NT7S/WillametteTransceiver/Pics/Pads2.png

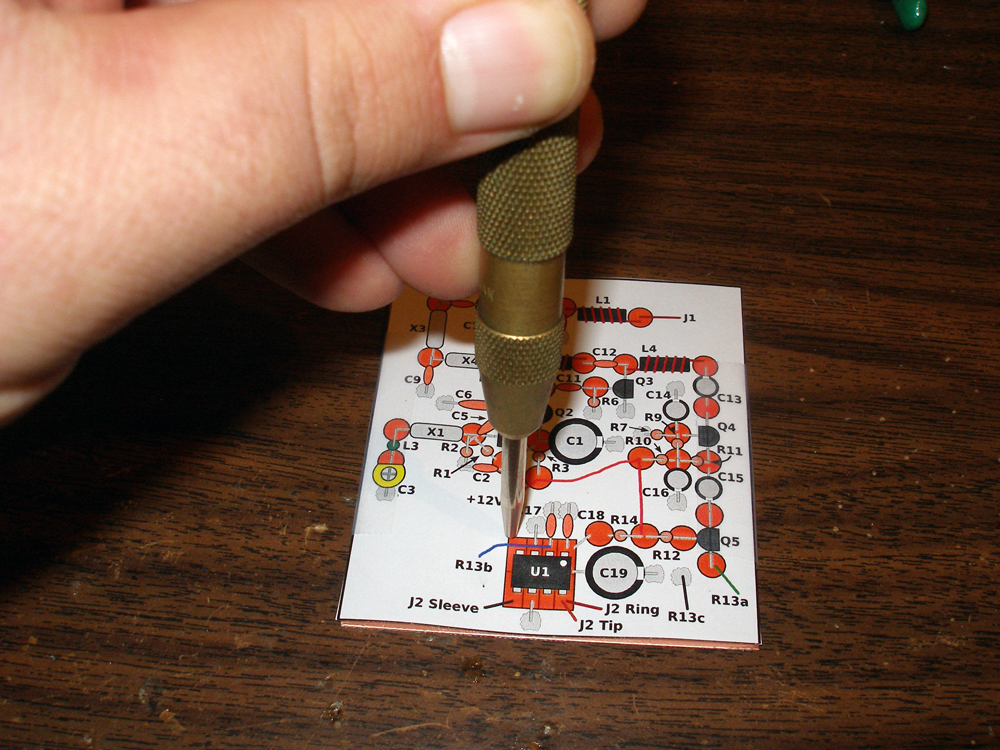
Pics/Pads2.png
