NT7S/WillametteTransceiver/Pics/Diode3.png

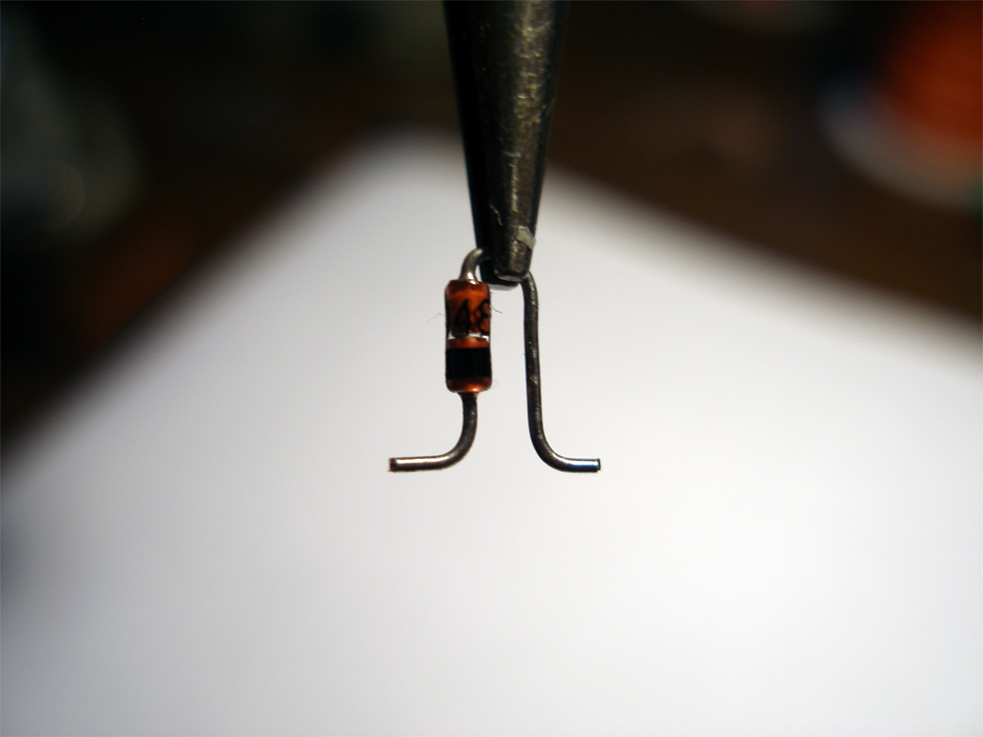
Pics/Diode3.png
