NT7S/WillametteTransceiver/Peaked AF Filter.pdf

Sheet1

Frequency Voltage (pp) dB
1.00E+02 | 6.560 | 0
2.00E+02 | 7.200 | 0.81
3.00E+02 | 7.600 | 1.28
4.00E+02 | 7.840 | 1.55
5.00E+02 | 8.080 | 1.81
6.00E+02 | 8.240 | 1.98
7.00E+02 | 8.240 | 1.98
8.00E+02 | 8.240 | 1.98
9.00E+02 | 8.320 | 2.06
1.00E+03 | 8.320 | 2.06
1.50E+03 | 8.080 | 1.81
2.00E+03 | 8.000 | 1.72
3.00E+03 | 7.600 | 1.28
4.00E+03 | 6.680 | 0.16
5.00E+03 | 2.960 | -6.91
7.50E+03 | 0.784 -18.45
1.00E+04 | 0.260 -28.04
1.50E+04 | 0.084 -37.85
2.00E+04 | 0.032 -46.24

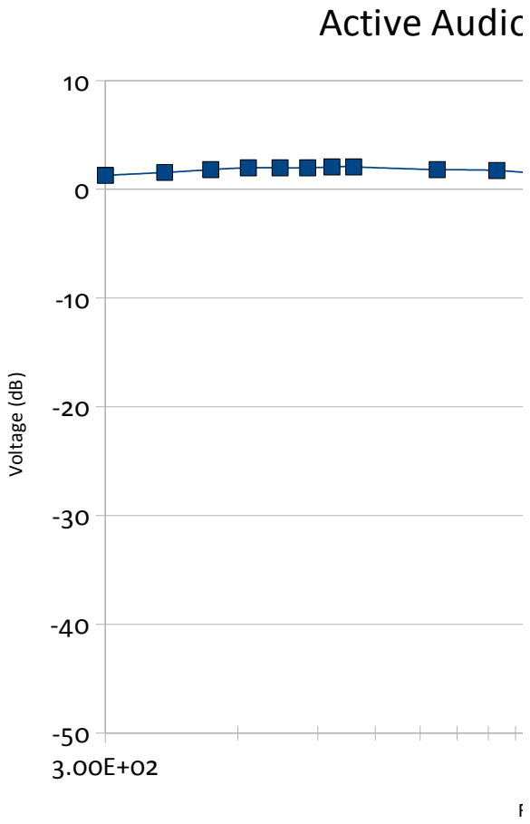
[picture p3: figure]
Active Audio Filter Response; Frequency (Hz); Voltage (dB)

Sheet1

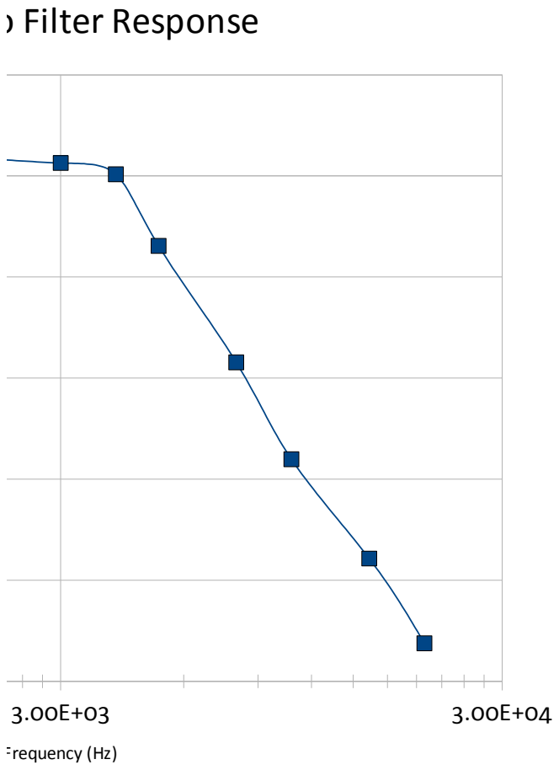
[picture p4: figure]
Active Audio Filter Response; Frequency (Hz)
