NT7S/WillametteTransceiver/Broadband-Noise-Generator.png

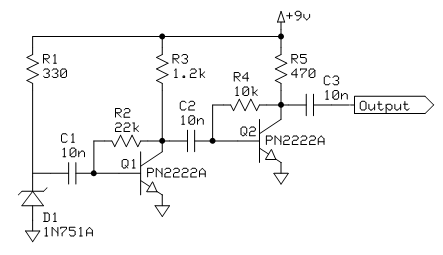
Broadband-Noise-Generator.png
