NT7S/WillametteTransceiver/New-Willamette-AF-Filter-Re.png

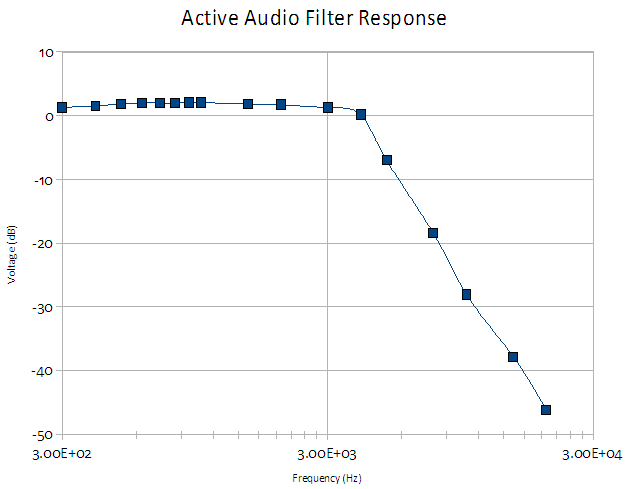
New-Willamette-AF-Filter-Re.png
