NT7S/WillametteTransceiver/Pics/Beta1.png

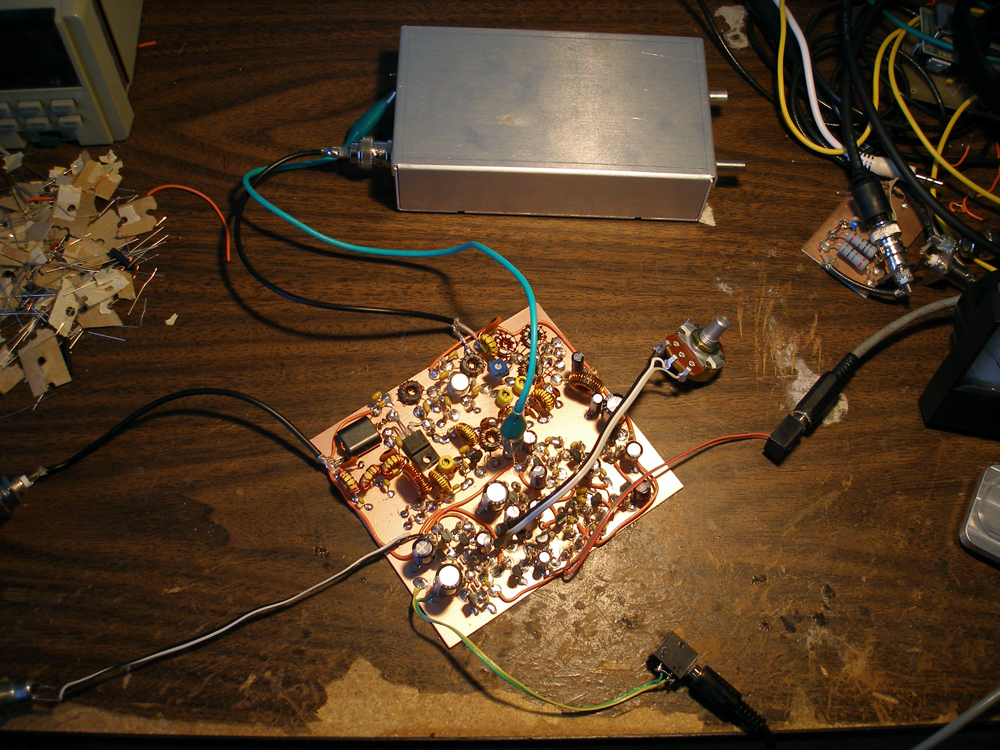
Pics/Beta1.png
