NT7S/WillametteTransceiver/Pics/Beta2.png

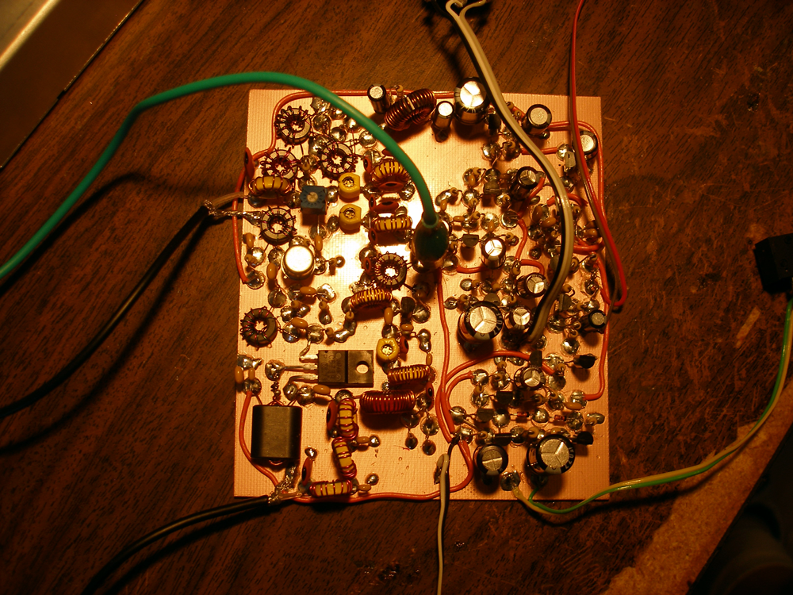
Pics/Beta2.png
