NT7S/WillametteTransceiver/Pics/Bifilar1.png

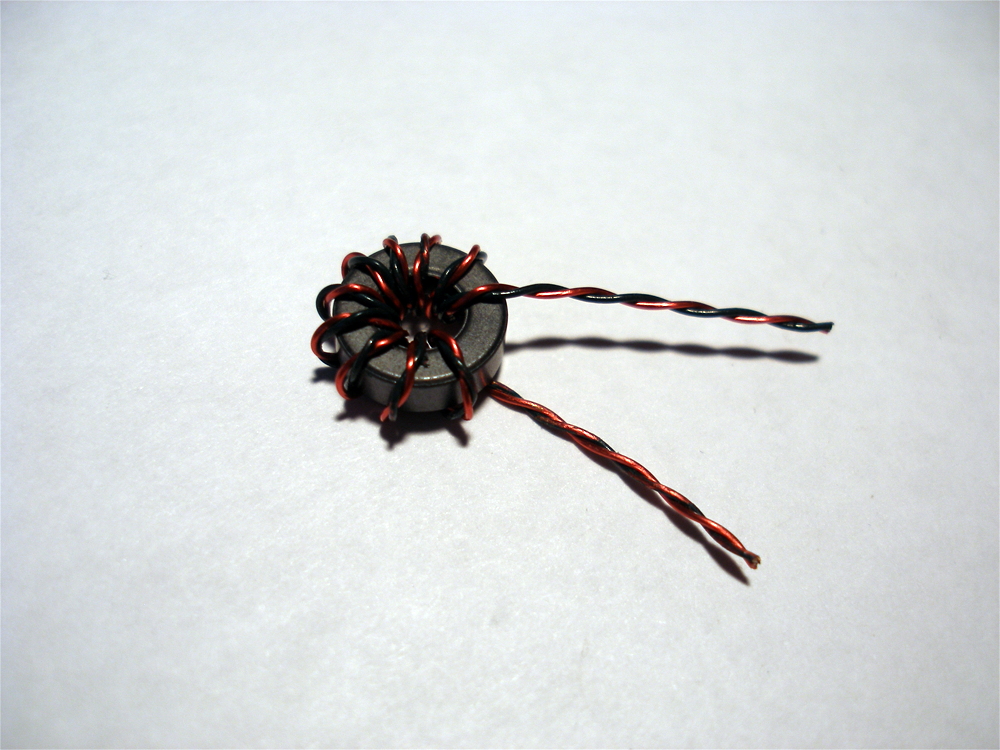
Pics/Bifilar1.png
