NT7S/WillametteTransceiver/Pics/Bifilar2.png

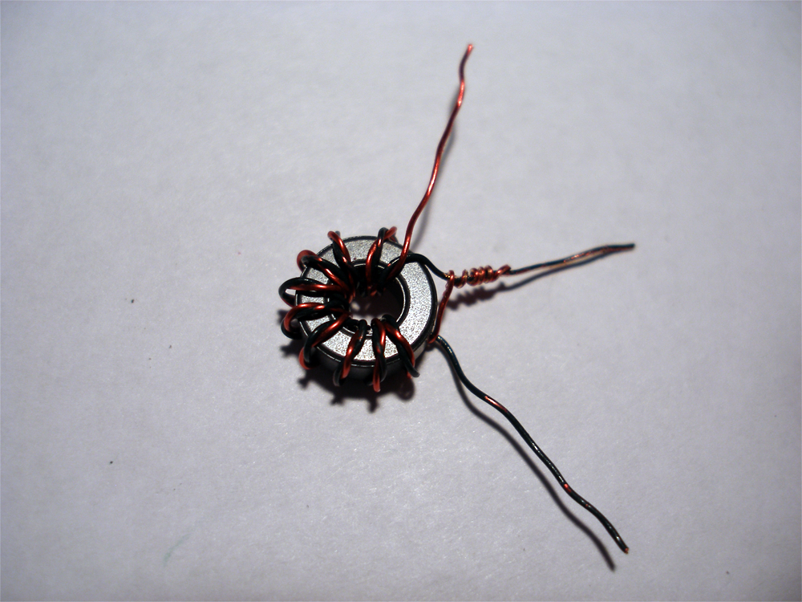
Pics/Bifilar2.png
