NT7S/WillametteTransceiver/Pics/Bifilar3.png

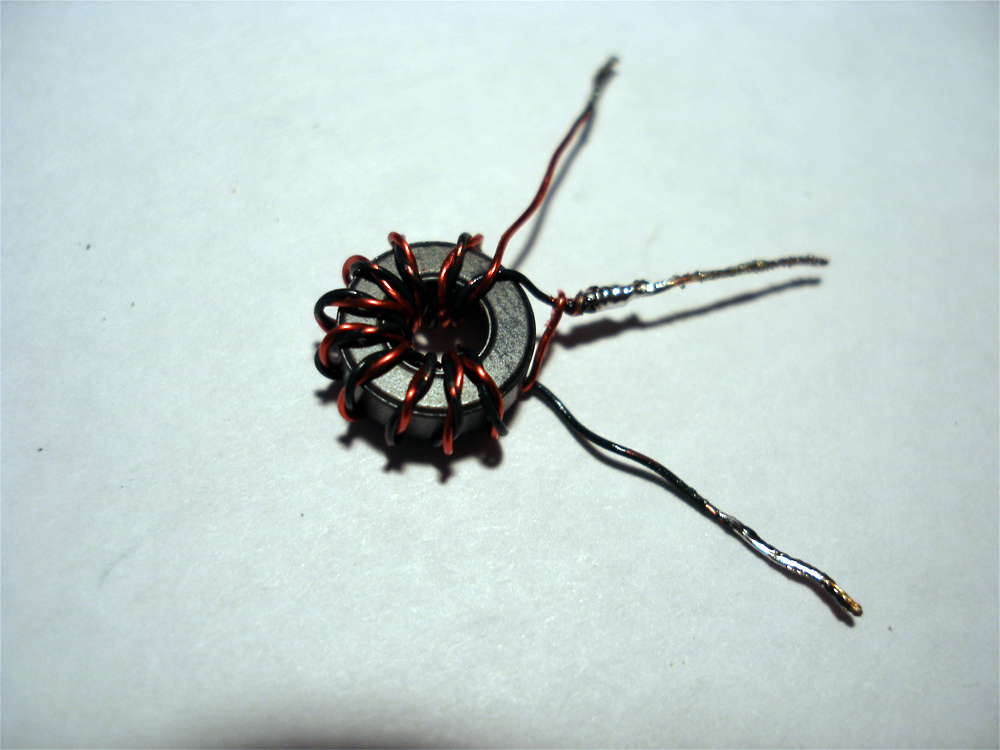
Pics/Bifilar3.png
