NT7S/WillametteTransceiver/Pics/Binocular1.png

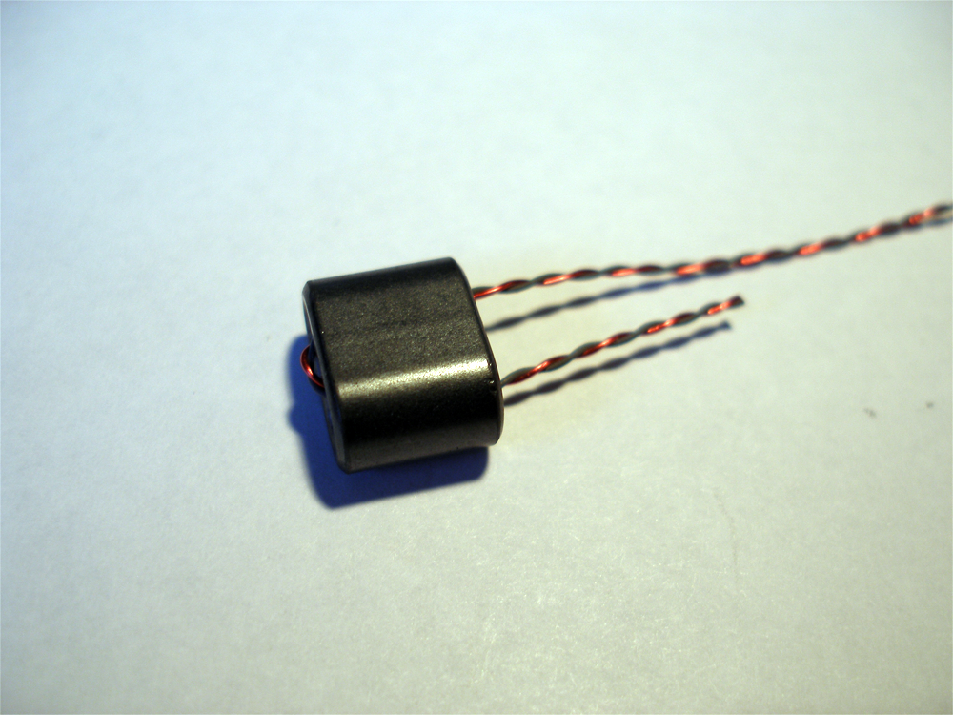
Pics/Binocular1.png
