NT7S/WillametteTransceiver/Pics/Binocular2.png

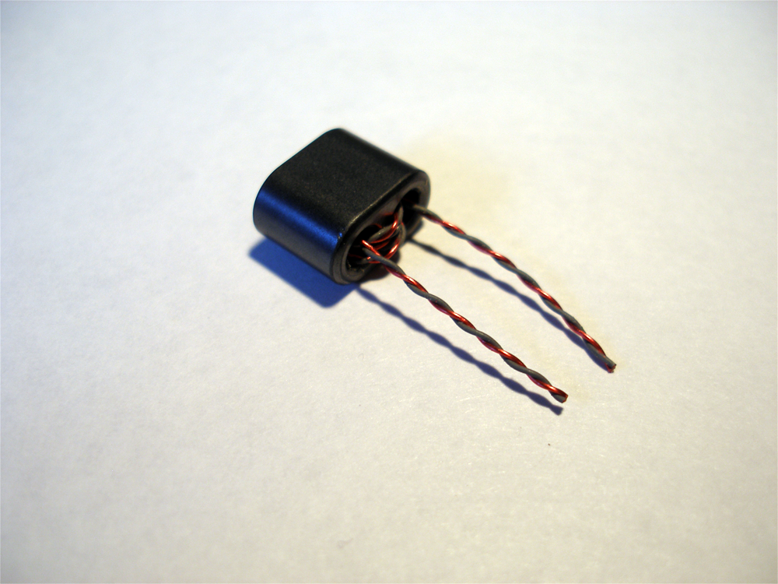
Pics/Binocular2.png
