NT7S/WillametteTransceiver/Pics/Binocular3.png

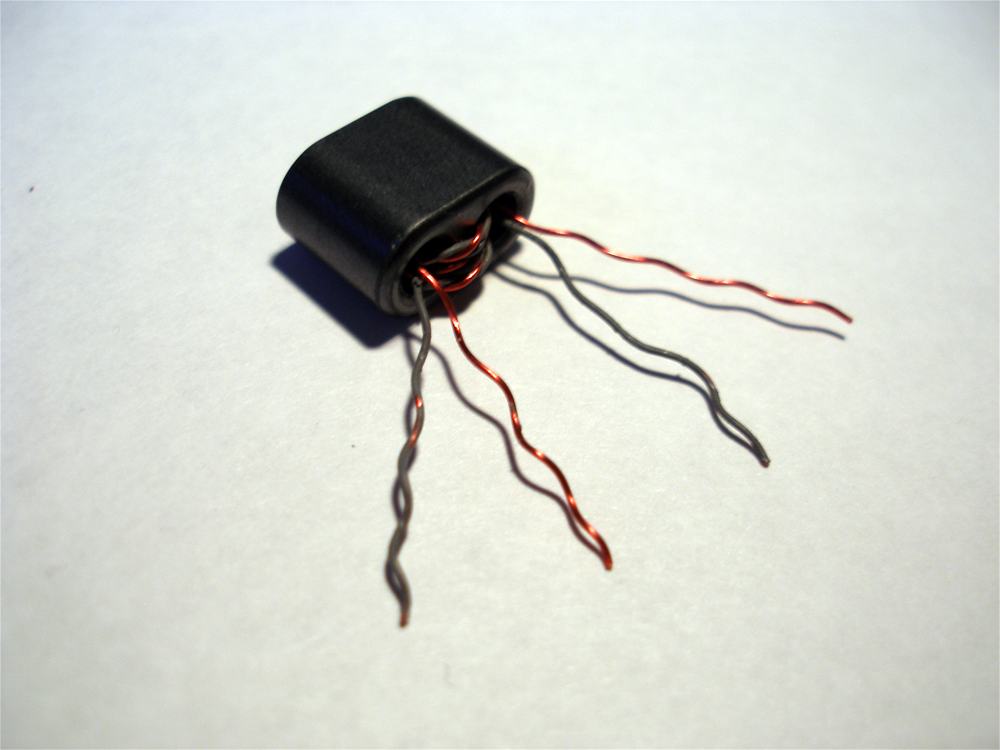
Pics/Binocular3.png
