NT7S/WillametteTransceiver/Pics/Binocular4.png

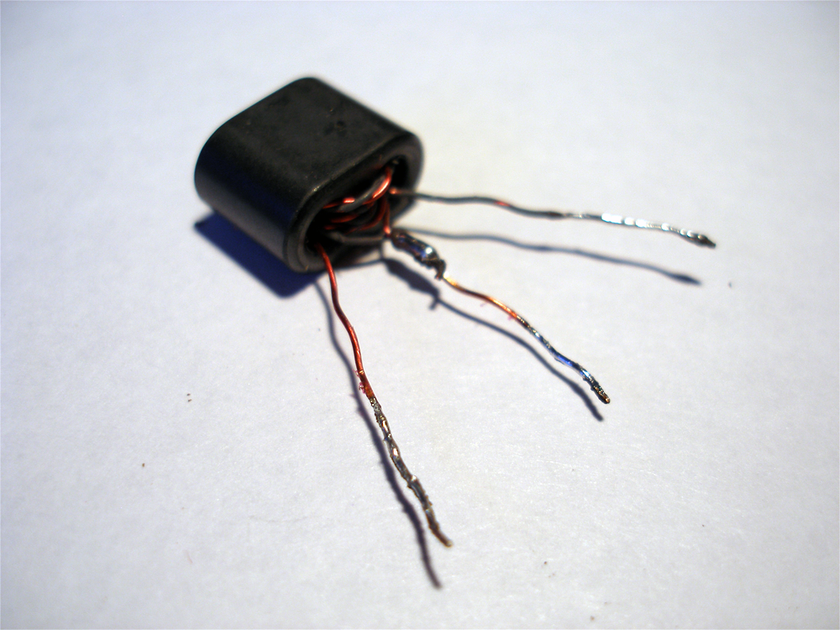
Pics/Binocular4.png
