NT7S/WillametteTransceiver/Pics/Capacitor1.png

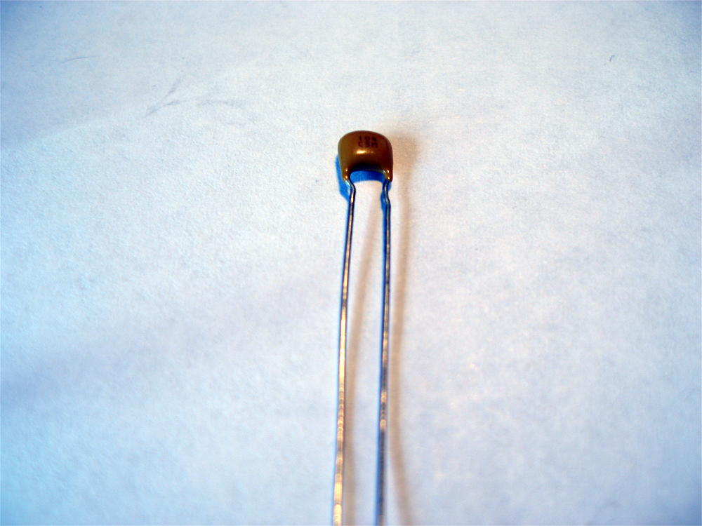
Pics/Capacitor1.png
