NT7S/WillametteTransceiver/Pics/Capacitor2.png

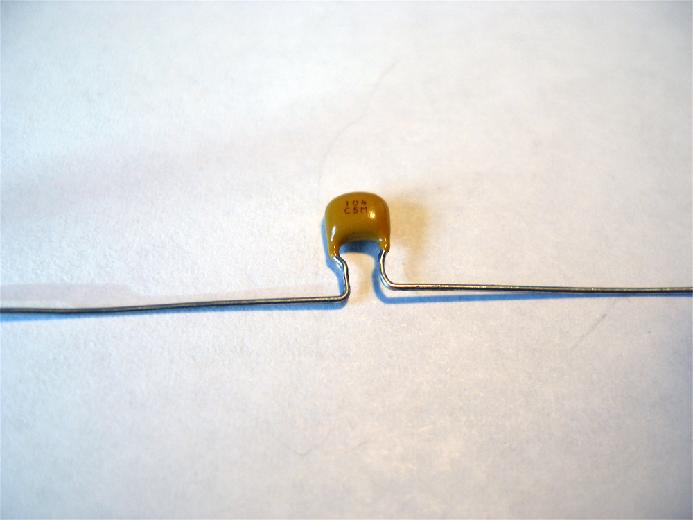
Pics/Capacitor2.png
