NT7S/WillametteTransceiver/Pics/Capacitor3.png

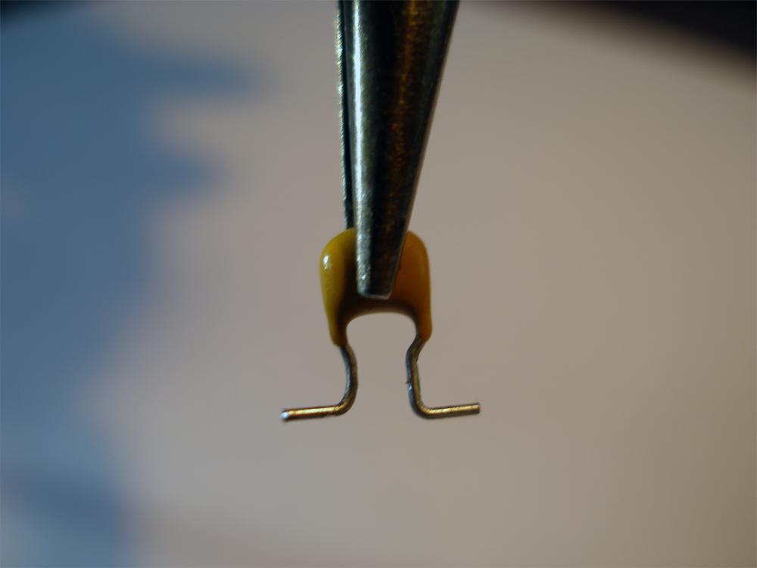
Pics/Capacitor3.png
