NT7S/WillametteTransceiver/Pics/Crystal1.png

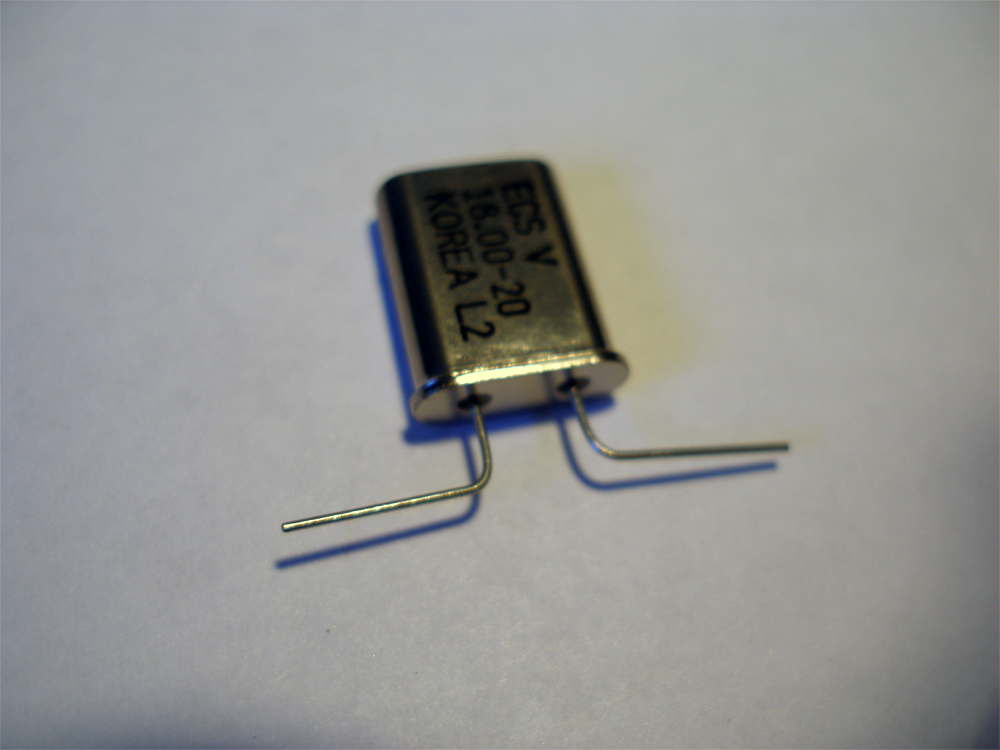
Pics/Crystal1.png
