NT7S/WillametteTransceiver/Pics/Crystal2.png

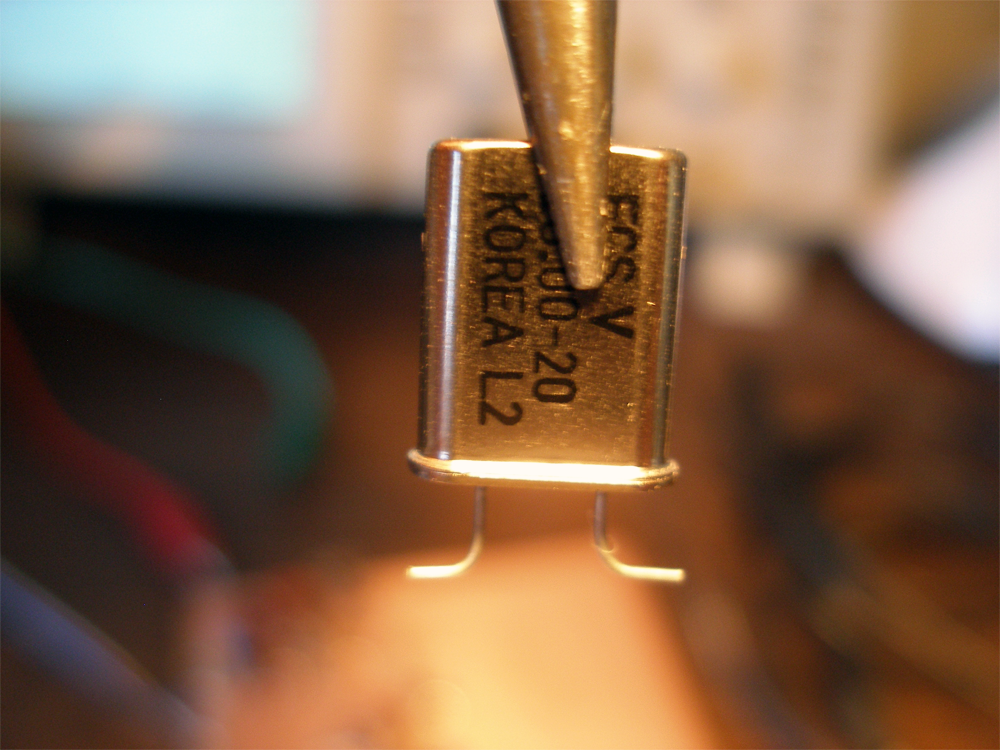
Pics/Crystal2.png
