NT7S/WillametteTransceiver/Pics/Diode1.png

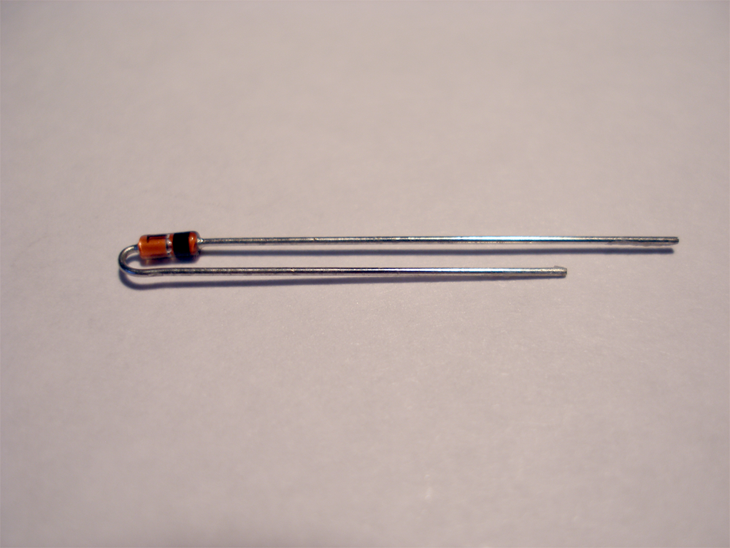
Pics/Diode1.png
