NT7S/WillametteTransceiver/Pics/Diode2.png

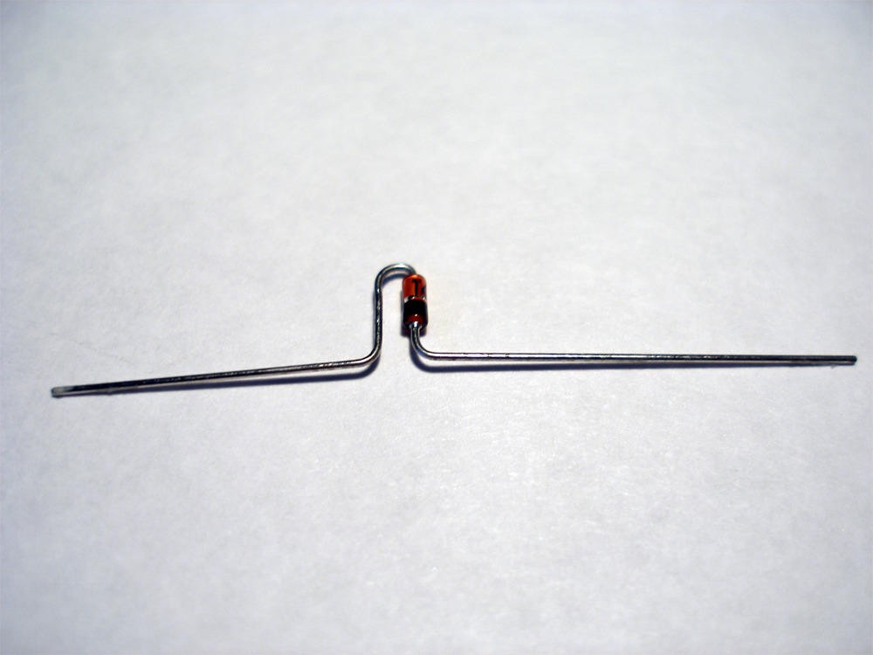
Pics/Diode2.png
