NT7S/WillametteTransceiver/Pics/IC1.png

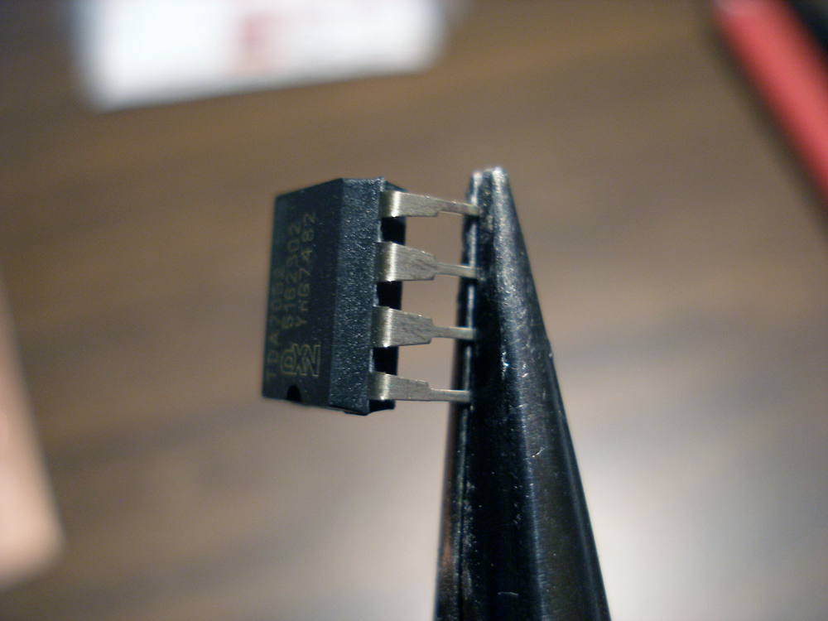
Pics/IC1.png
