NT7S/WillametteTransceiver/Pics/IC2.png

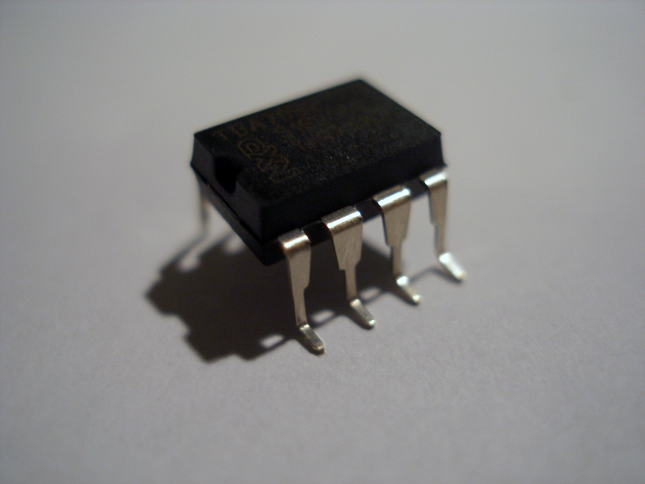
Pics/IC2.png
