NT7S/WillametteTransceiver/Pics/IC3.png

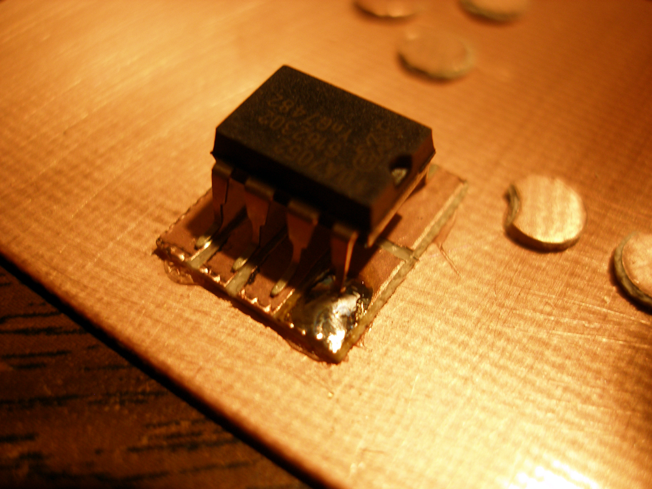
Pics/IC3.png
