NT7S/WillametteTransceiver/Pics/P1270686.JPG

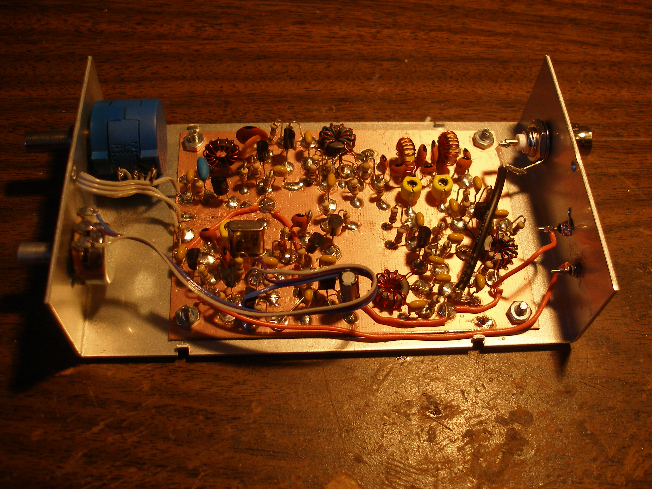
Pics/P1270686.JPG
