NT7S/WillametteTransceiver/Pics/P1270688.JPG

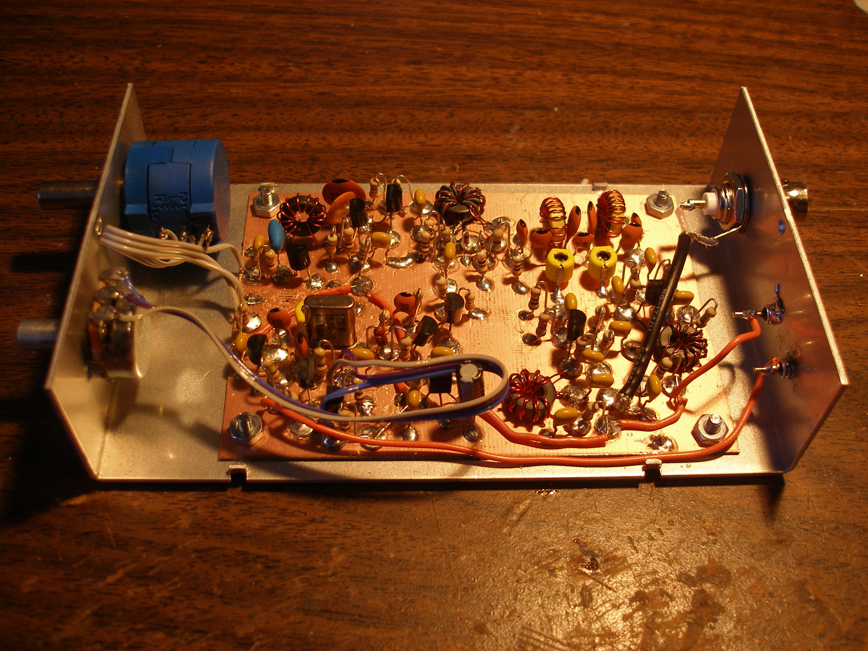
Pics/P1270688.JPG
