NT7S/WillametteTransceiver/Pics/P2020691.JPG

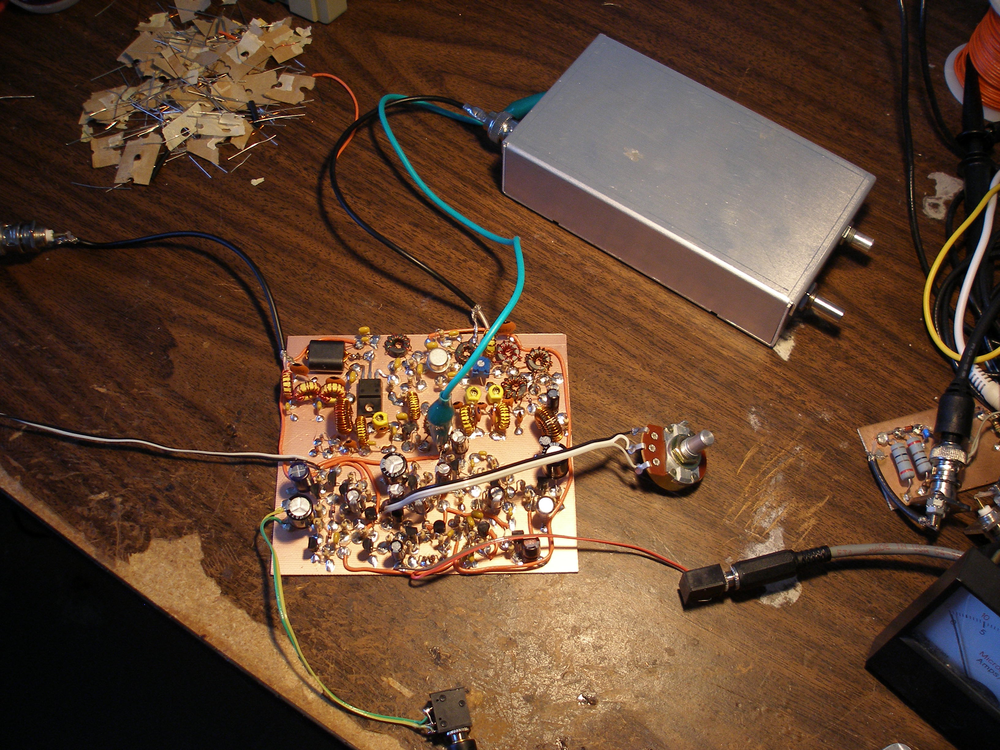
Pics/P2020691.JPG
