NT7S/WillametteTransceiver/Pics/P4180227.JPG

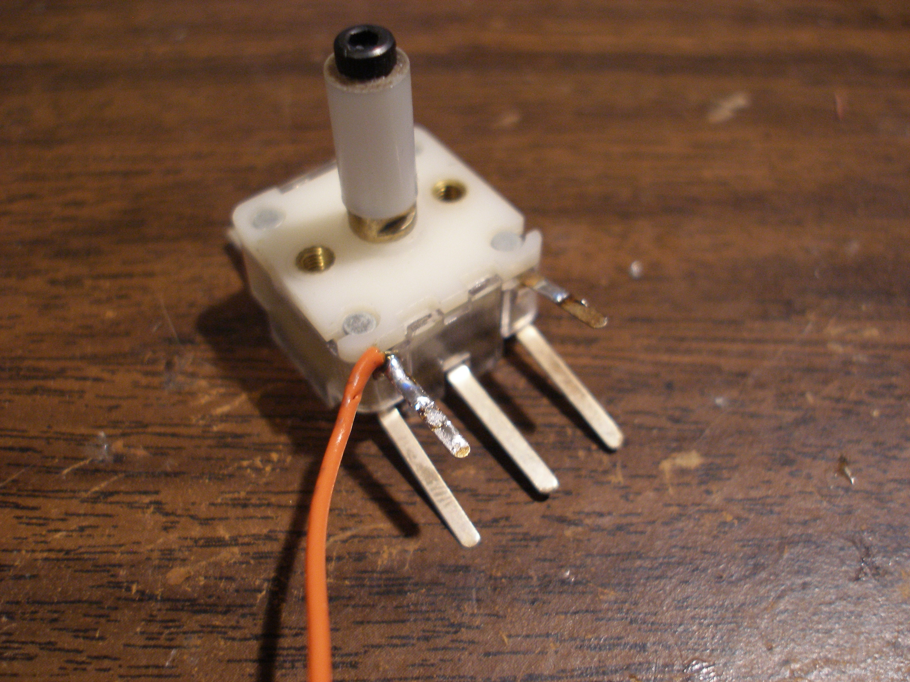
Pics/P4180227.JPG
