NT7S/WillametteTransceiver/Pics/P4180230.JPG

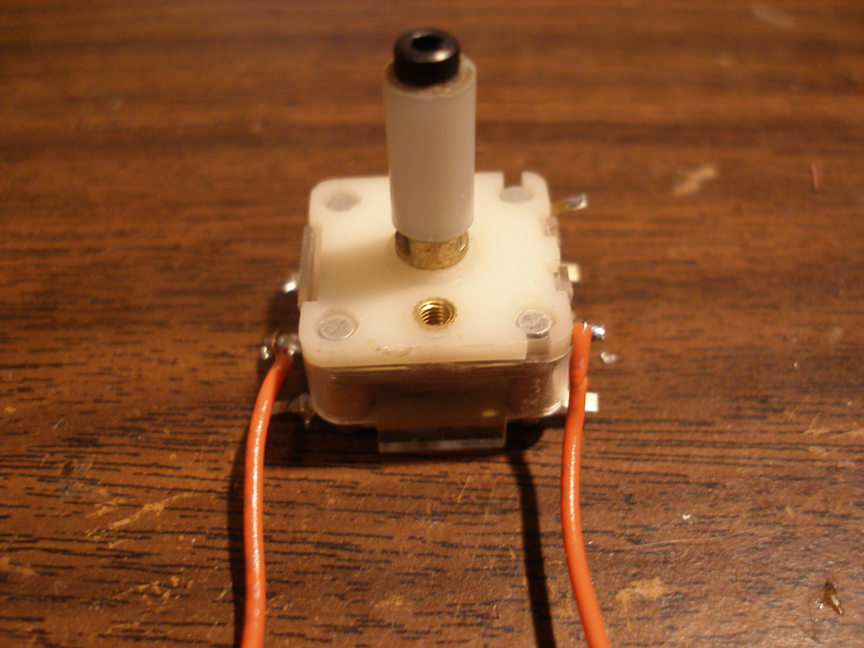
Pics/P4180230.JPG
