NT7S/WillametteTransceiver/Pics/P6070236.JPG

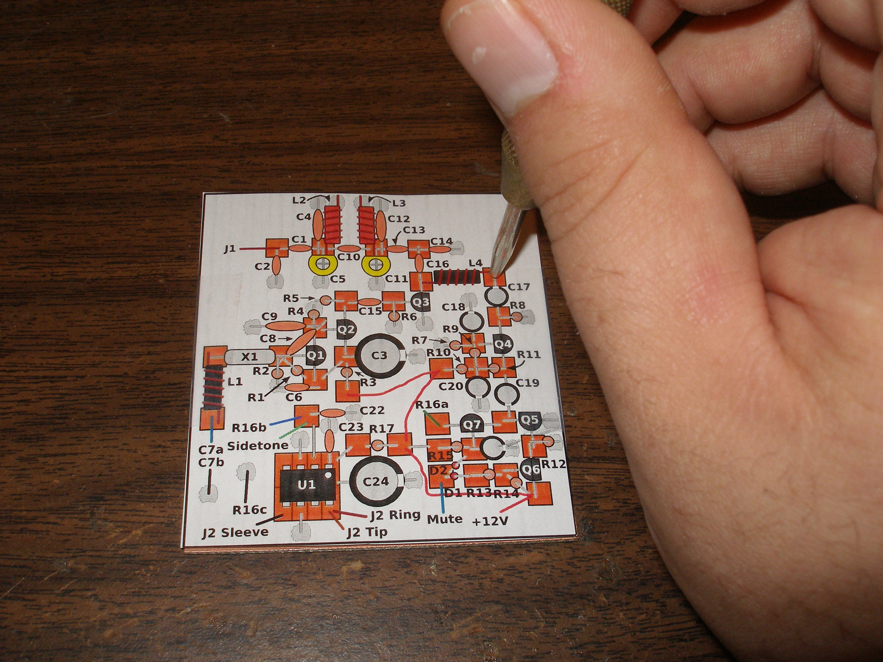
Pics/P6070236.JPG
