NT7S/WillametteTransceiver/Pics/P6070240.JPG

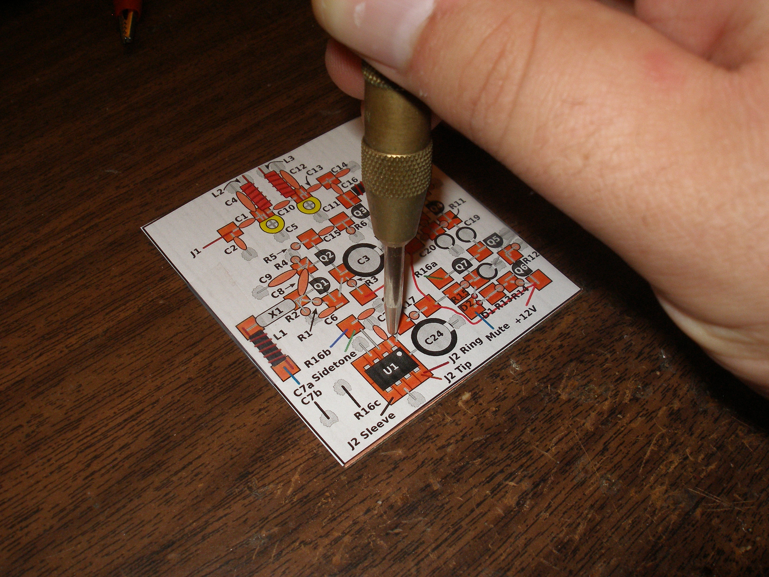
Pics/P6070240.JPG
