NT7S/WillametteTransceiver/Pics/P6070242.JPG

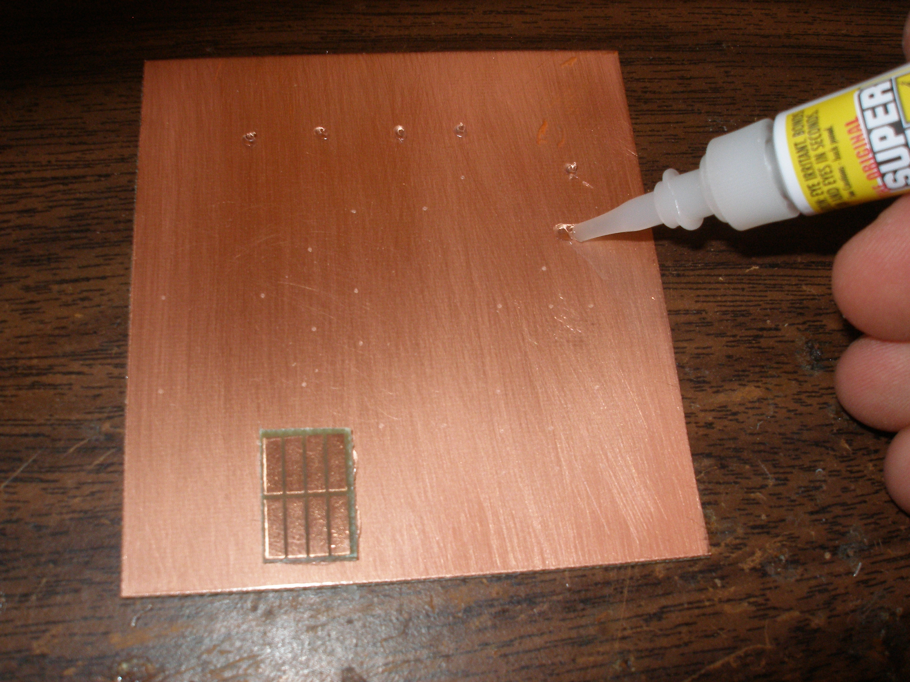
Pics/P6070242.JPG
