NT7S/WillametteTransceiver/Pics/P6070250.JPG

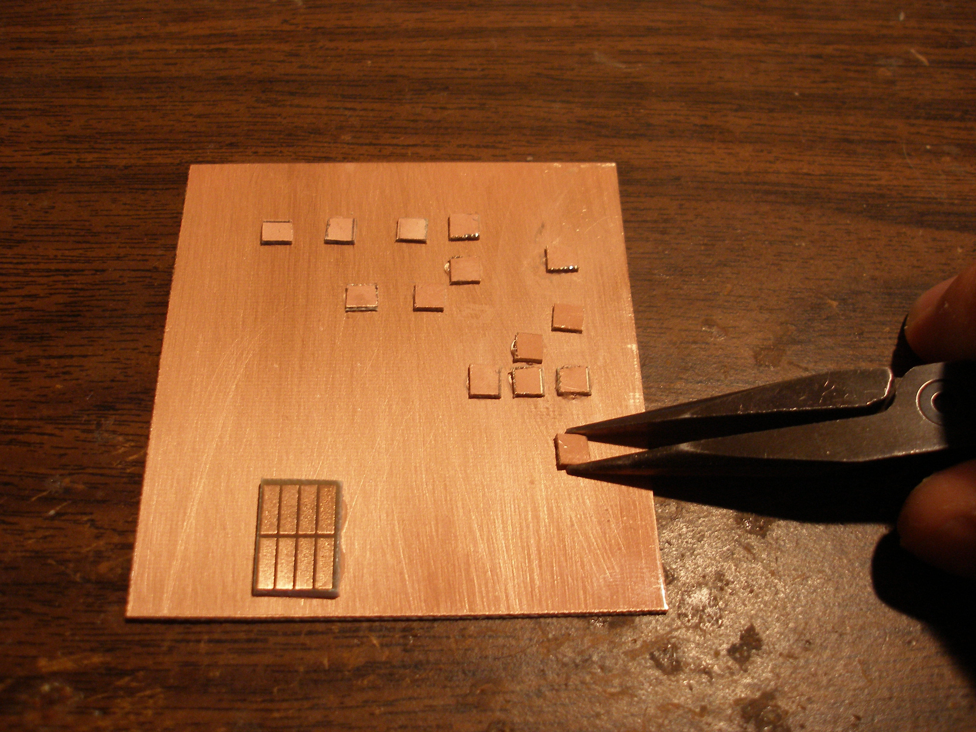
Pics/P6070250.JPG
