NT7S/WillametteTransceiver/Pics/Pads1.png

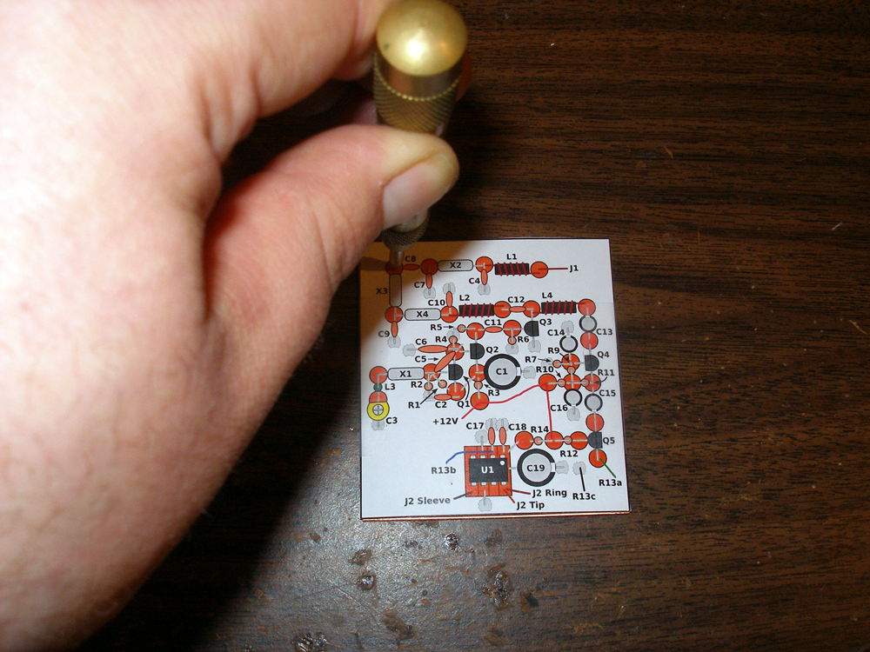
Pics/Pads1.png
