NT7S/WillametteTransceiver/Pics/Pads3.png

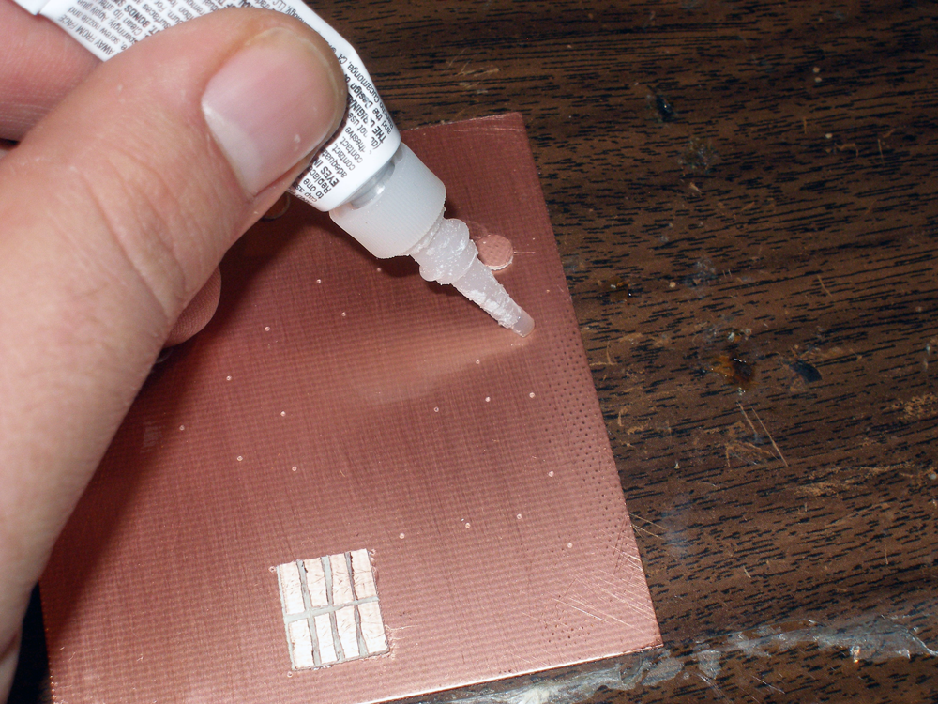
Pics/Pads3.png
