NT7S/WillametteTransceiver/Pics/Pads4.png

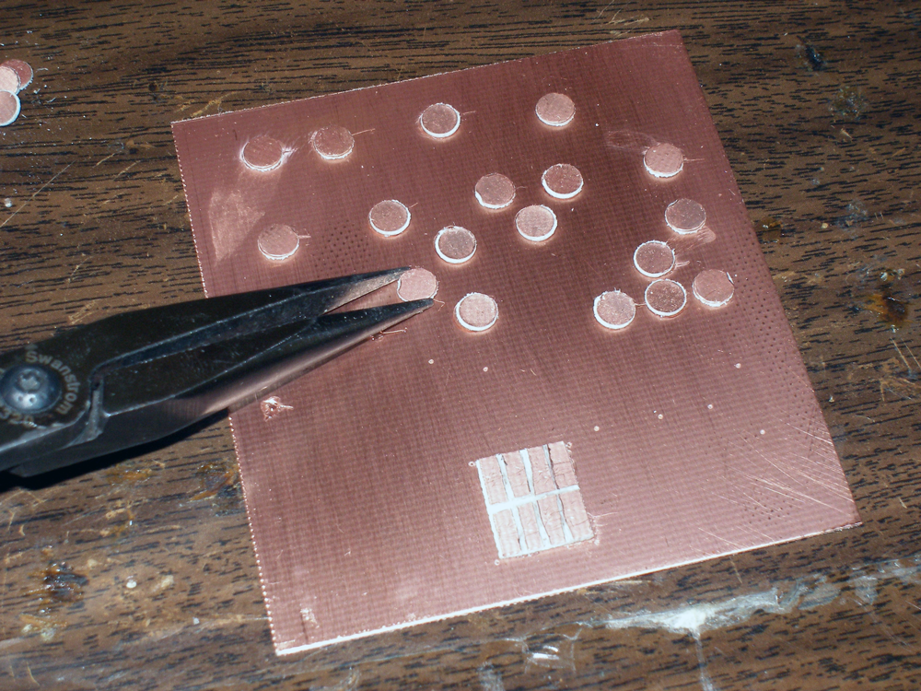
Pics/Pads4.png
