NT7S/WillametteTransceiver/Pics/Pot1.png

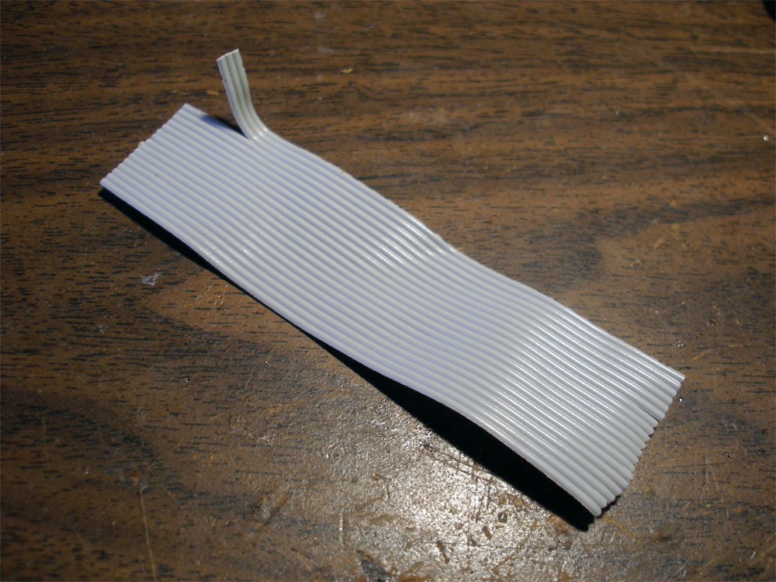
Pics/Pot1.png
