NT7S/WillametteTransceiver/Pics/Pot2.png

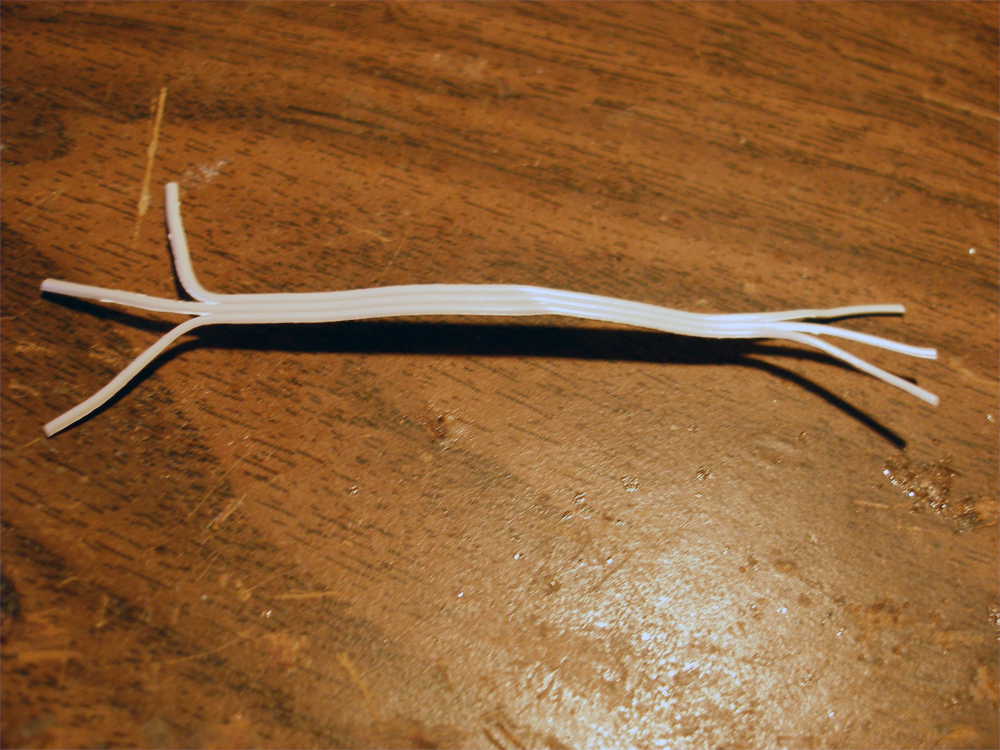
Pics/Pot2.png
