NT7S/WillametteTransceiver/Pics/Pot3.png

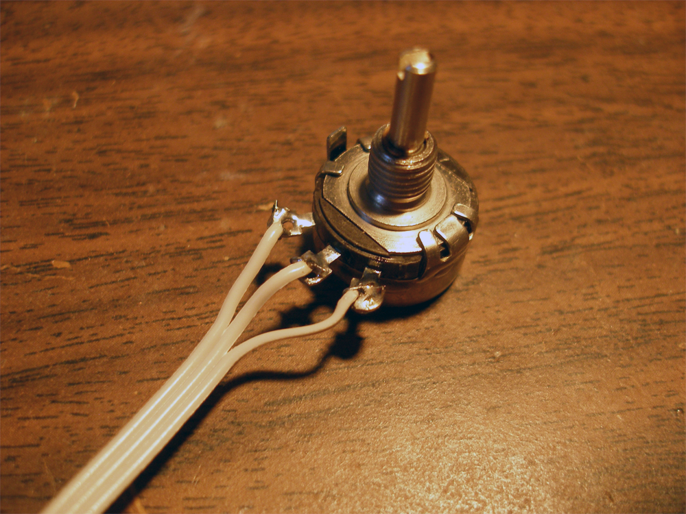
Pics/Pot3.png
