NT7S/WillametteTransceiver/Pics/Resistor1.png

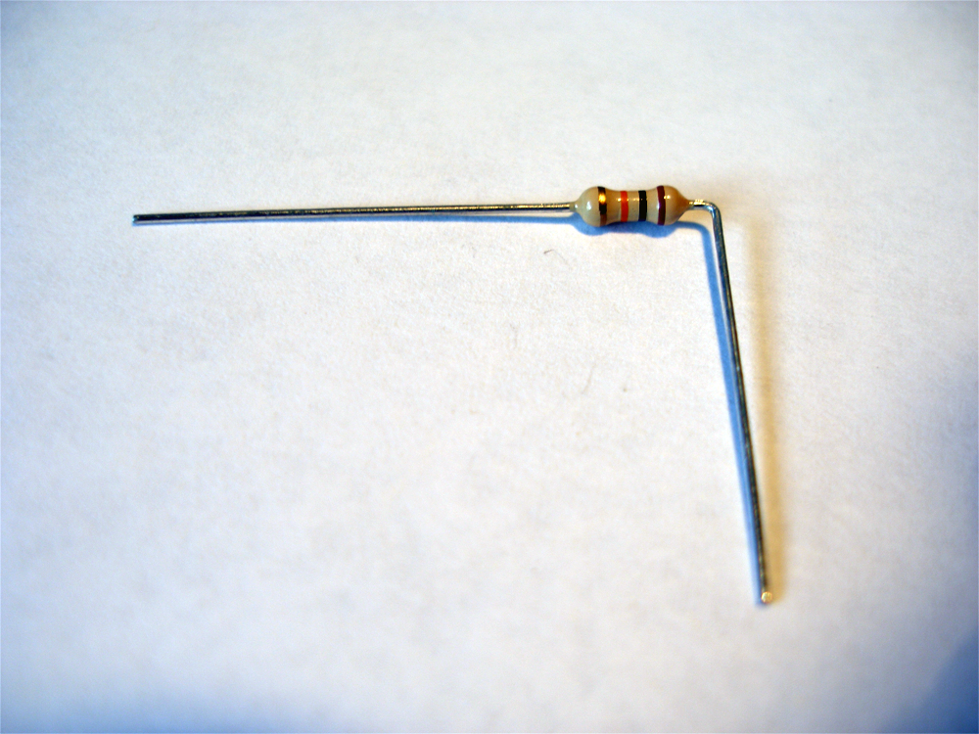
Pics/Resistor1.png
