NT7S/WillametteTransceiver/Pics/Resistor2.png

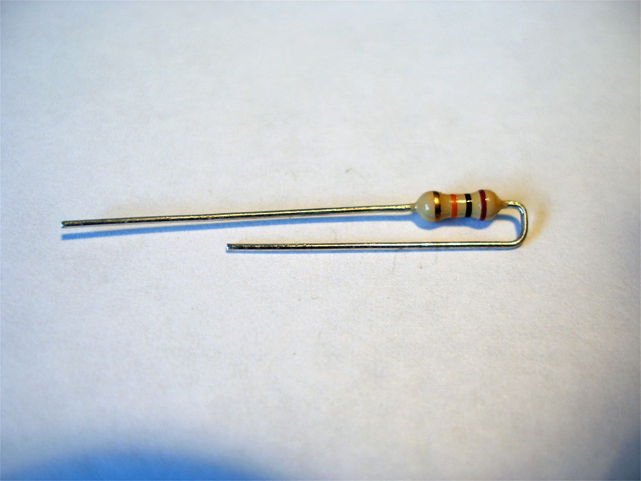
Pics/Resistor2.png
