NT7S/WillametteTransceiver/Pics/Resistor3.png

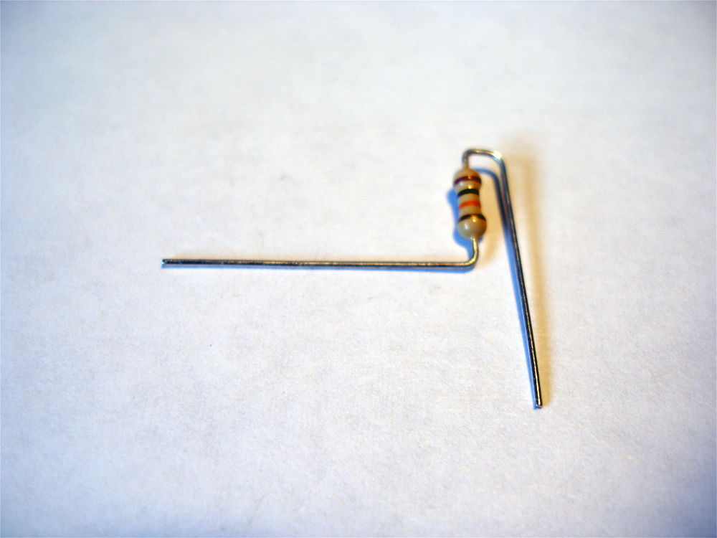
Pics/Resistor3.png
