NT7S/WillametteTransceiver/Pics/Resistor4.png

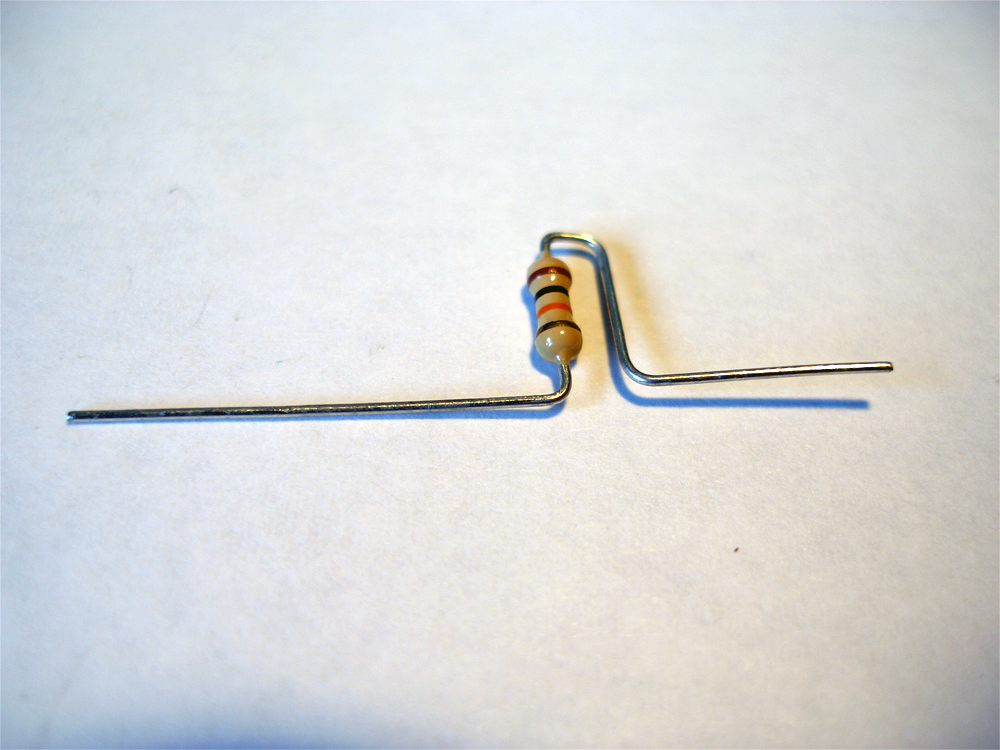
Pics/Resistor4.png
