NT7S/WillametteTransceiver/Pics/Resistor5.png

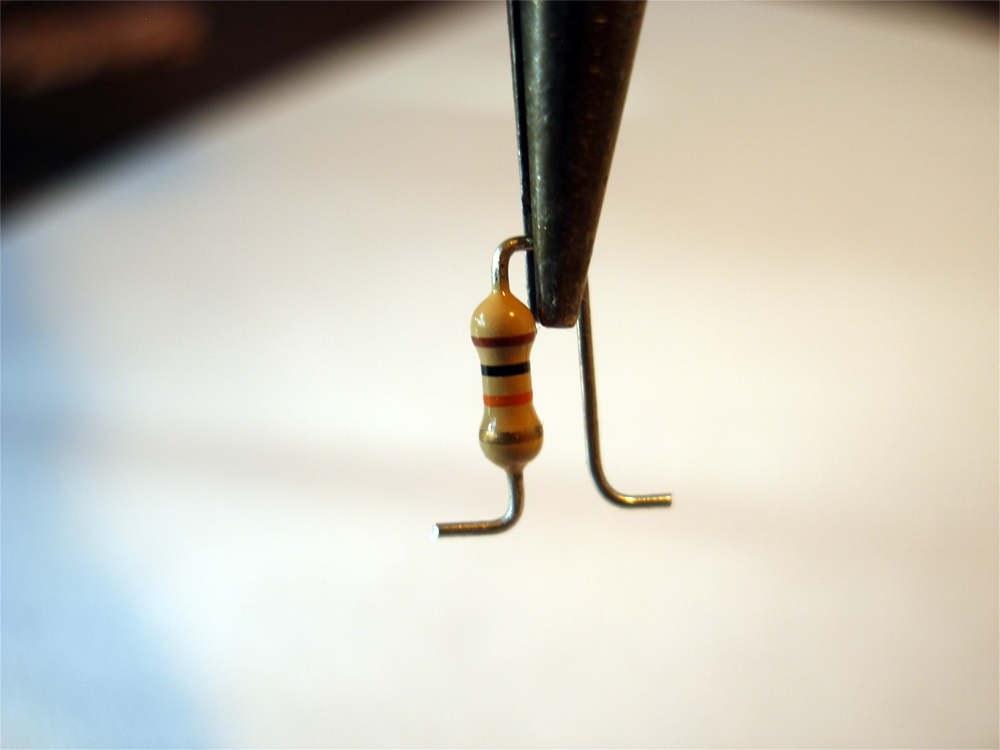
Pics/Resistor5.png
