NT7S/WillametteTransceiver/Pics/TO220.png

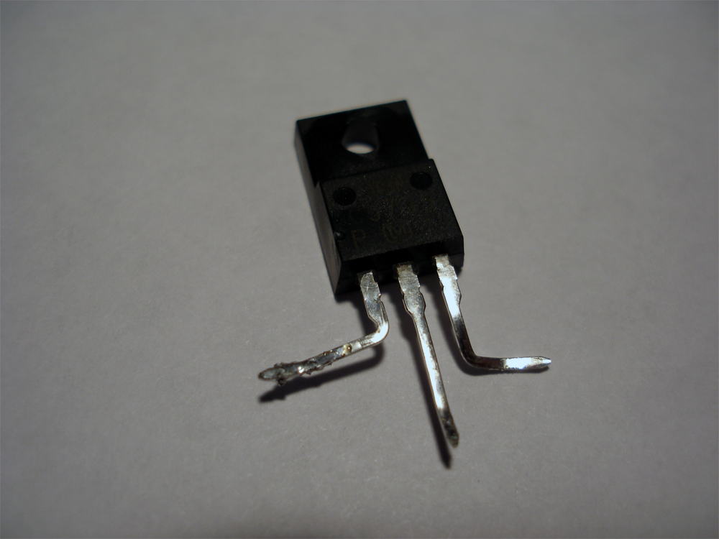
Pics/TO220.png
