NT7S/WillametteTransceiver/Pics/Toroid1.png

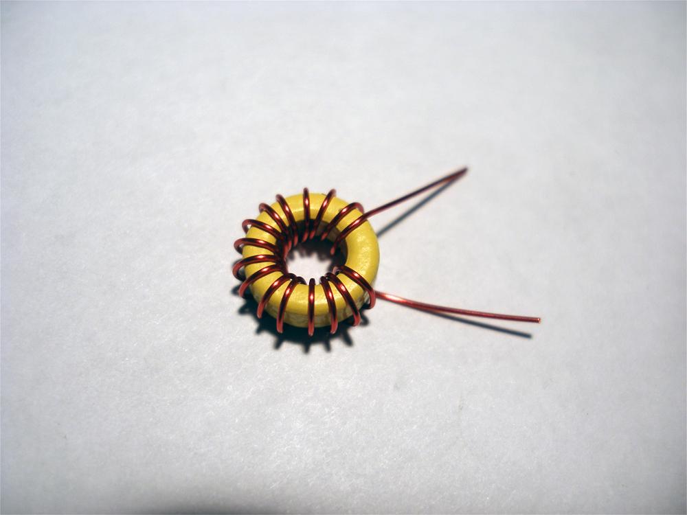
Pics/Toroid1.png
