NT7S/WillametteTransceiver/Pics/Toroid2.png

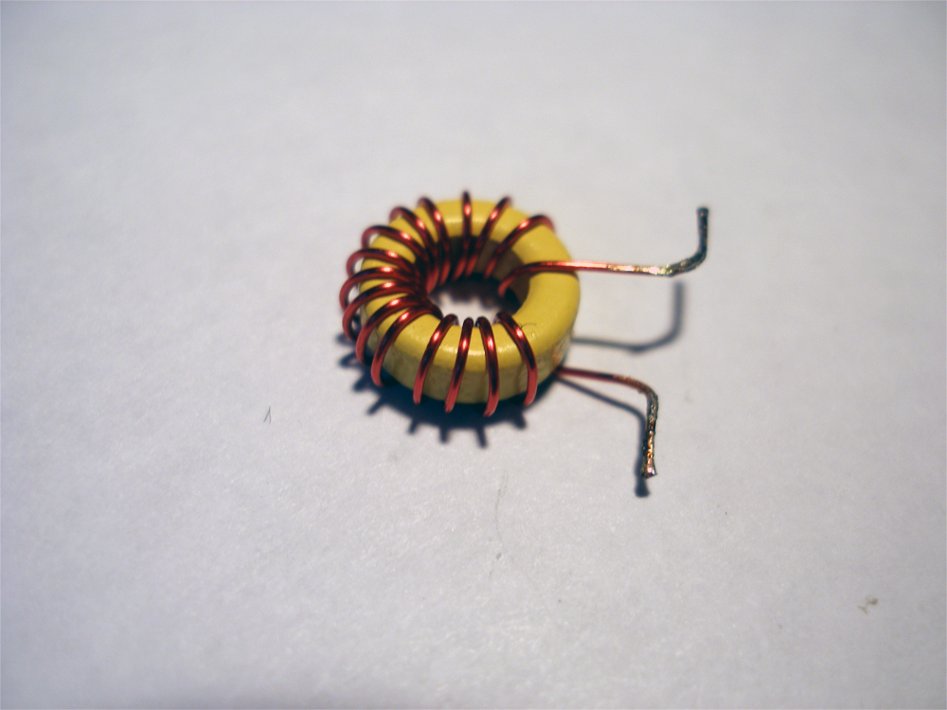
Pics/Toroid2.png
