NT7S/WillametteTransceiver/Pics/Transformer1.png

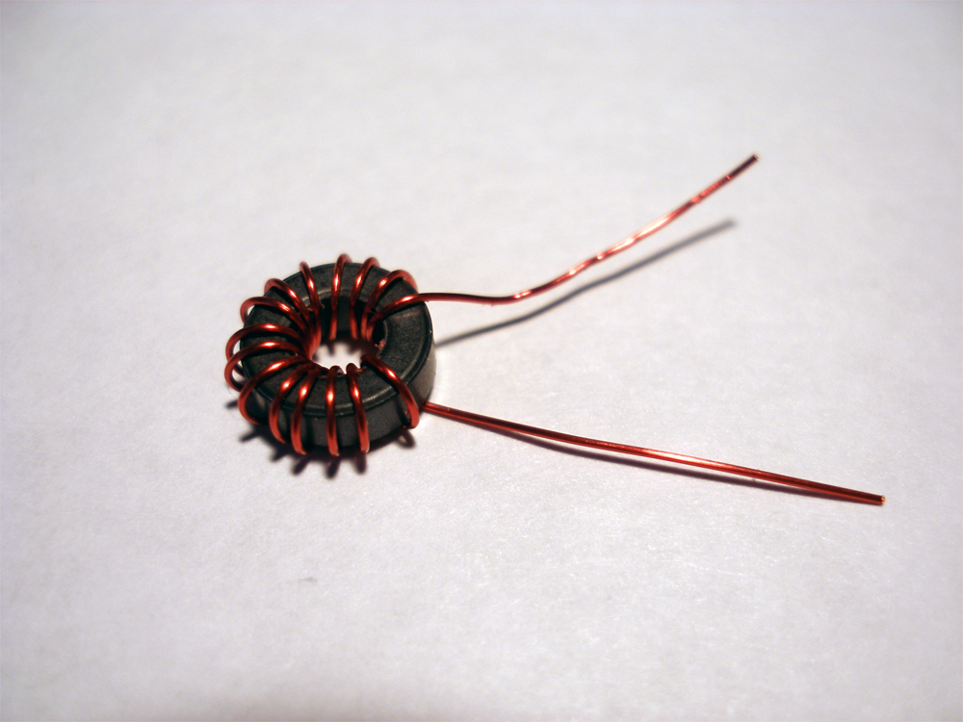
Pics/Transformer1.png
