NT7S/WillametteTransceiver/Pics/Transformer2.png

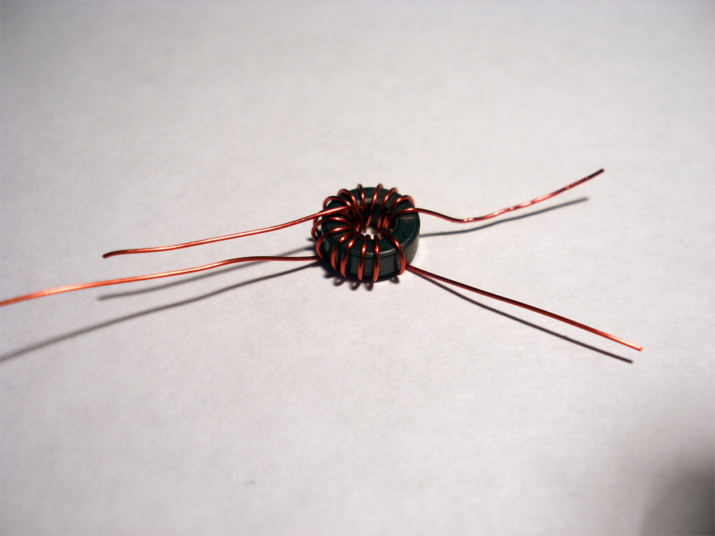
Pics/Transformer2.png
