NT7S/WillametteTransceiver/Pics/Transformer3.png

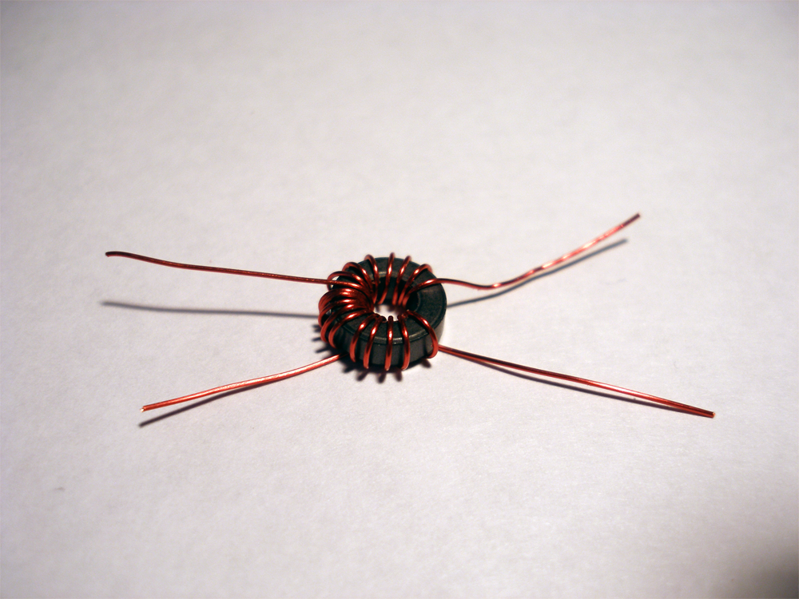
Pics/Transformer3.png
