NT7S/WillametteTransceiver/Pics/Transistor1.png

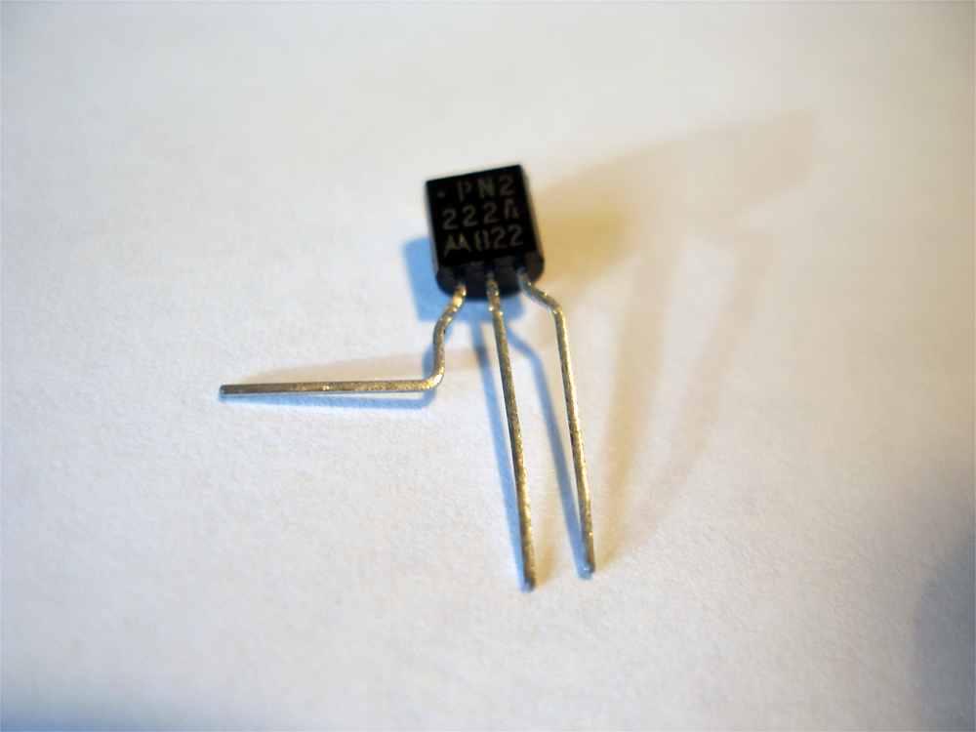
Pics/Transistor1.png
