NT7S/WillametteTransceiver/Pics/Transistor2.png

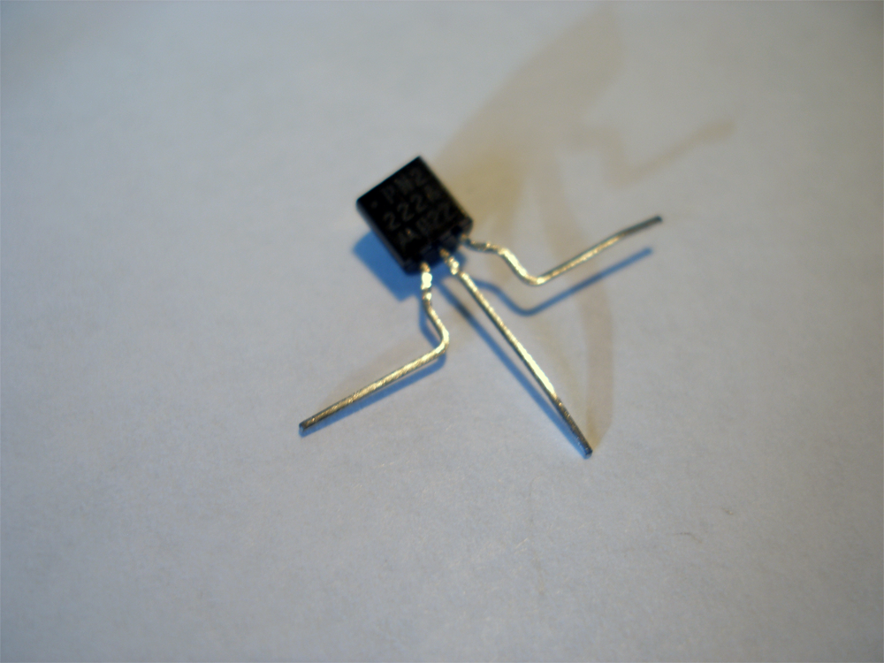
Pics/Transistor2.png
