NT7S/WillametteTransceiver/Pics/Transistor3.png

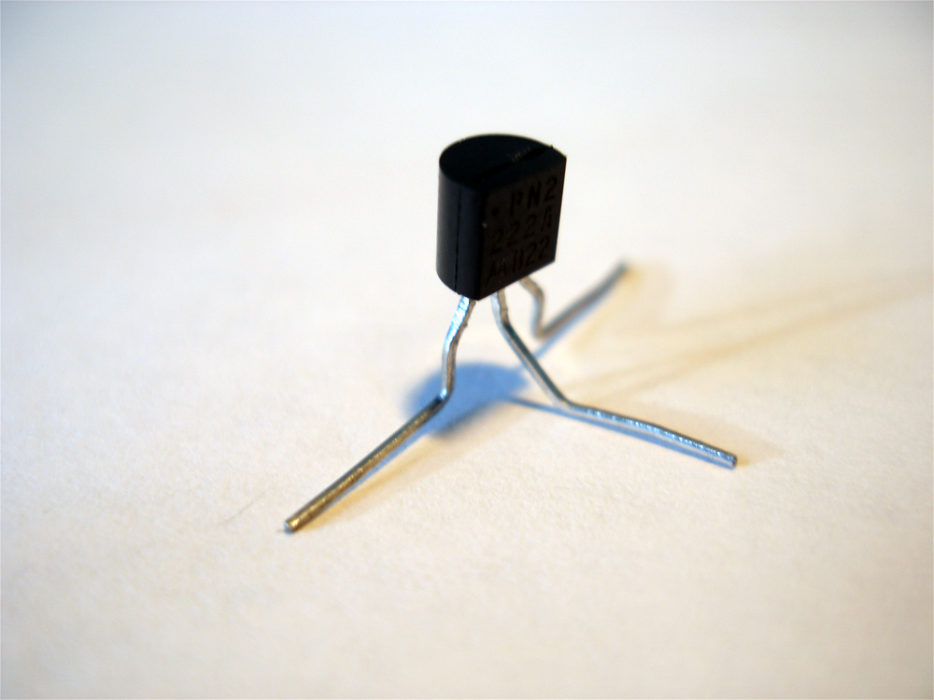
Pics/Transistor3.png
