NT7S/WillametteTransceiver/Pics/Transistor4.png

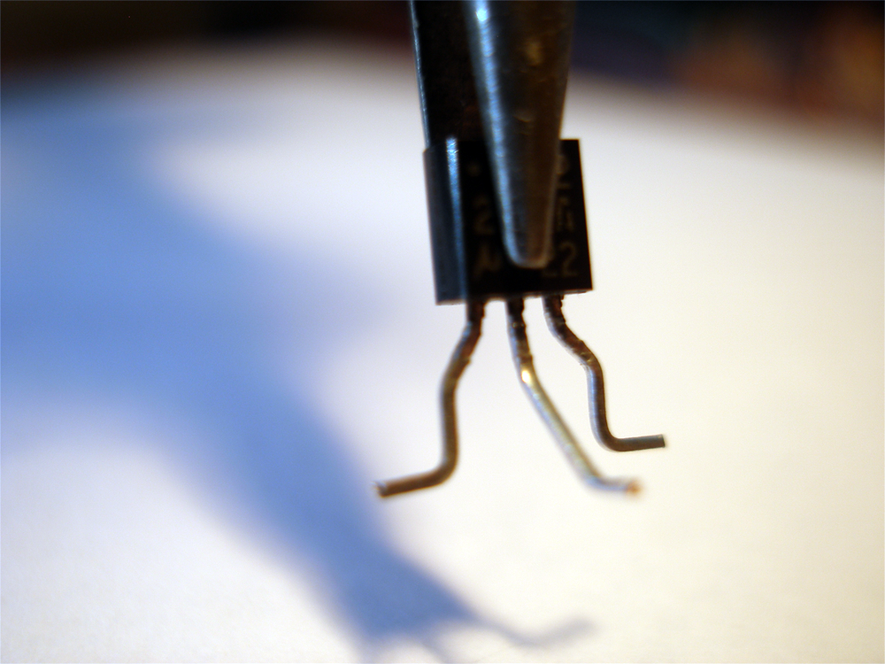
Pics/Transistor4.png
