NT7S/WillametteTransceiver/Pics/Trifilar1.png

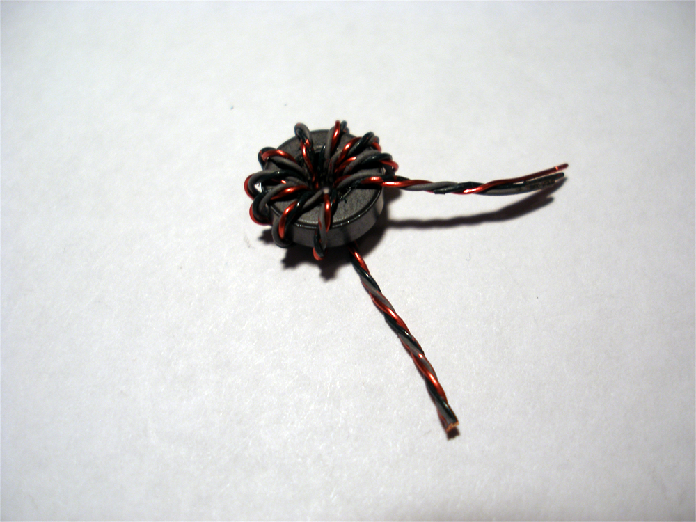
Pics/Trifilar1.png
