NT7S/WillametteTransceiver/Pics/Trifilar2.png

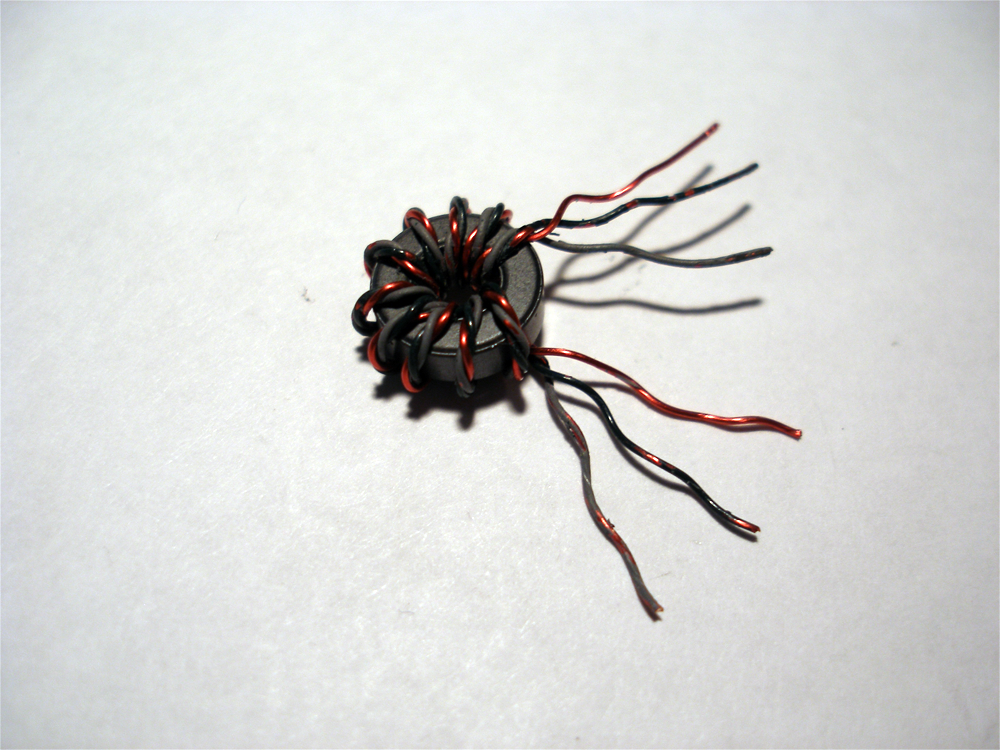
Pics/Trifilar2.png
