NT7S/WillametteTransceiver/Pics/Trifilar3.png

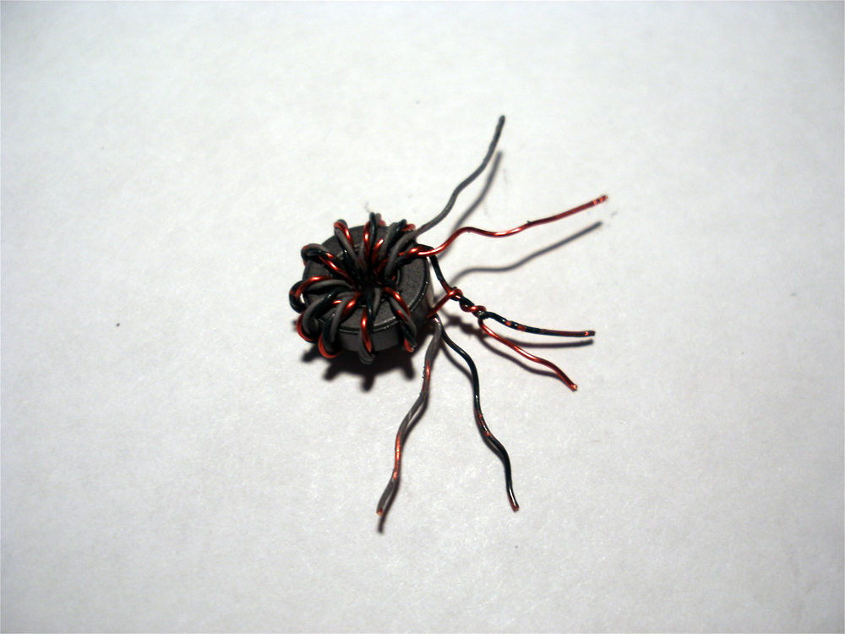
Pics/Trifilar3.png
