NT7S/WillametteTransceiver/Pics/Trifilar4.png

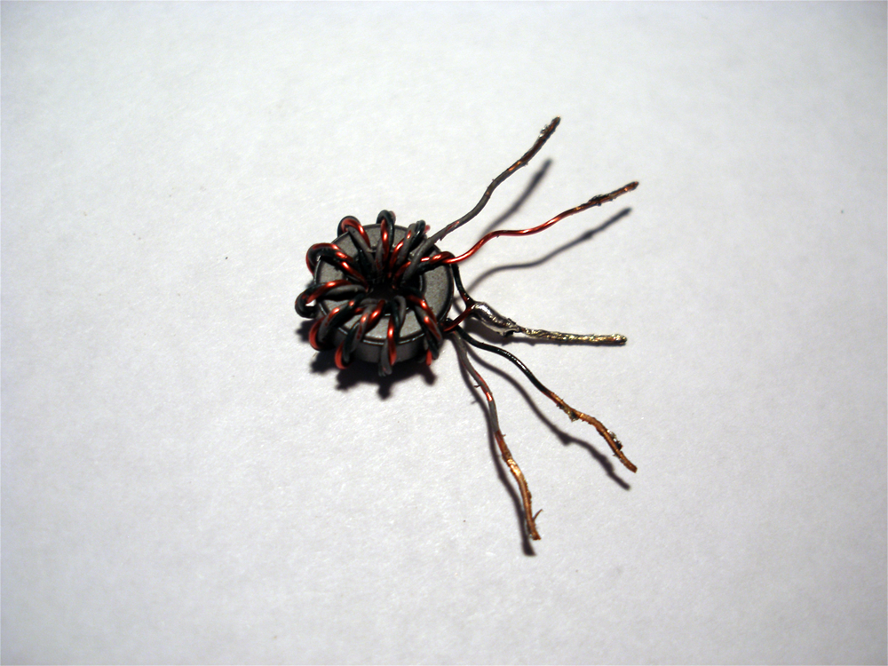
Pics/Trifilar4.png
