NT7S/WillametteTransceiver/RF-Probe.png

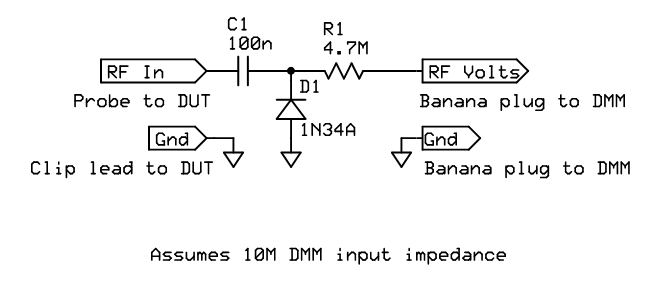
RF-Probe.png
