NT7S/WillametteTransceiver/Willamette AF Filter Model.png

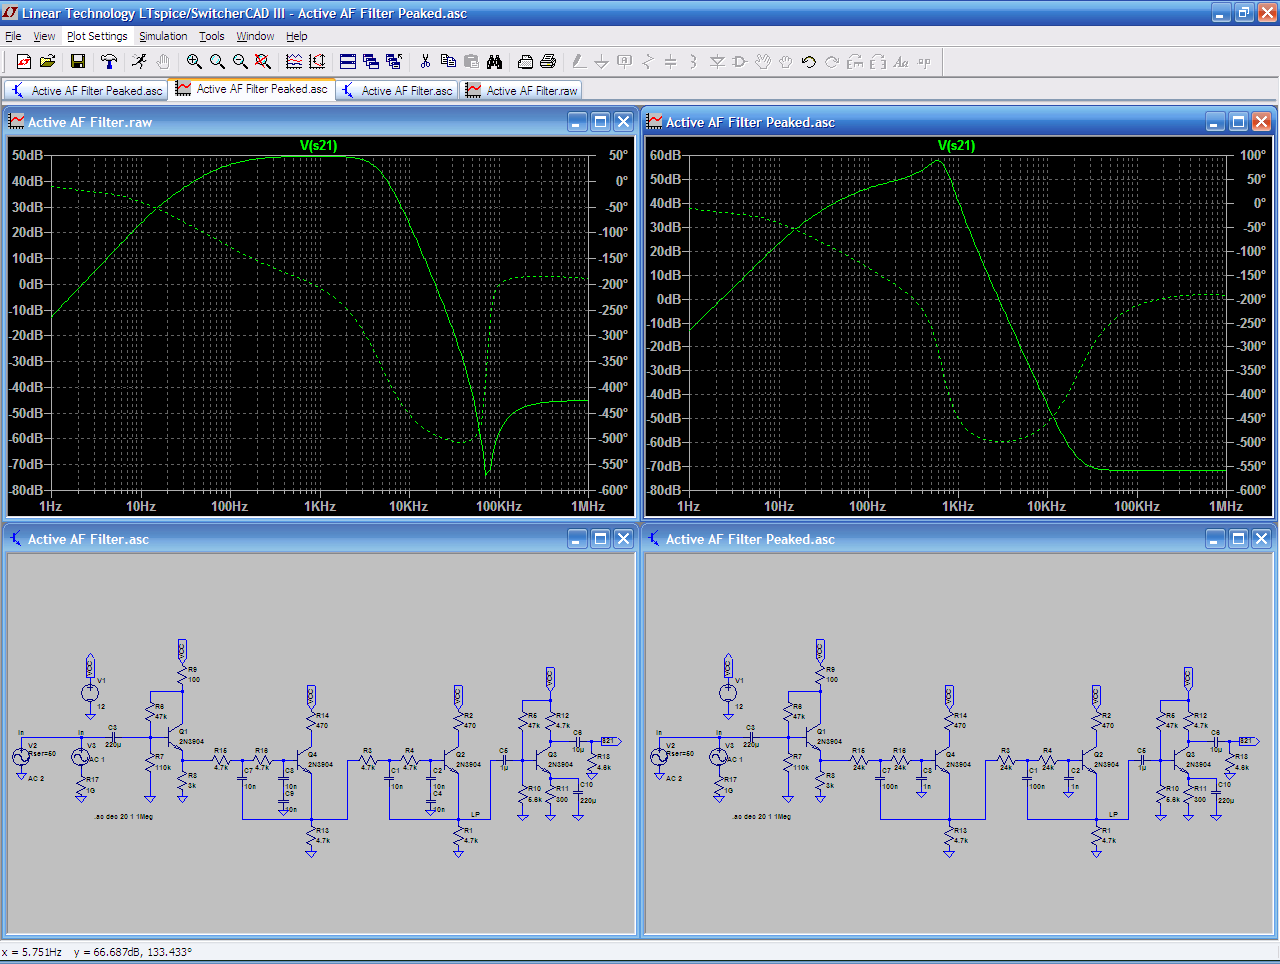
Willamette AF Filter Model.png
