NT7S/WillametteTransceiver/qrp-l Group Project BOM.xls

C1 | 100n
C2 | 100n
C3 | 100n
C4 | 470
C5 | 270
C6 | 100n
C7 | 18
C8 | 22
C9 | 45
C10 | 100
C11 | 2.2
C12 | 100
C13 | 45
C14 | 18
C15 | 22
C16 | 22
C17 | 100n
C18 | 45
C19 | 33
C20 | 100n
C21 | 100n
C22 | 100n
C23 | 100n
C24 | 100n
C25 | 100n
C26 | 100n
C27 | 100n
C28 | 100n
C29 | 100n
C30 | 220
C31 | 10n
C32 | 100n
C33 | 18
C34 | 1u
C35 | 100n
C36 | 470
C37 | 22
C38 | 45
C39 | 470
C40 | 100n
C41 | 100n
C42 | 18
C43 | 22
C44 | 45
C45 | 100
C46 | 2.2
C47 | 100
C48 | 45
C49 | 18
C50 | 22
C51 | 1u
C52 | 1u
C53 | 220u
C54 | 10u
C55 | 10u
C56 | 10n
C57 | 10n
C58 | 10n
C59 | 10u
C60 | 10n
C61 | 10n
C62 | 10n
C63 | 10u
C64 | 10u
C65 | 10u
C66 | 10u
C67 | 220u
C68 | 10u
C69 | 220u
C70 | 100u
C71 | 100u
C72 | 100n
C73 | 100n
C74 | 100n
C75 | 100n
C76 | 100n
C77 | 100n
C78 | 10n
C79 | 22
C80 | 100n
C81 | 180
C82 | 390
C83 | 390
C84 | 180
C85 | 10n
C86 | 1u
C87 | 100n
C88 | 100n
C89 | 100n
C90 | 100n
C91 | 100n
D1 | MV209
D2 | 1N4148
D3 | 1N4148
D4 | 1N4148
D5 | 1N4148
D6 | 1N4007
D11 | 1N4148
D12 | 1N4148
D13 | 1N4148
D14 | 1N4148
D15 | 1N4148
D16 | 1N4148
D17 | 1N4148
D18 | 1N4148
D19 | 1N4148
D7-10 | 1N4148
J1 | Phones
J2 | BNC
J3 | Key
L1 | 43u
L2 | 700n
L3 | 700n
L4 | 5.6u
L5 | 284n
L6 | 2.7u
L7 | 2.7u
L8 | 700n
L9 | 700n
L10 | 2.7m
L11 | 5.68u
L12 | 738n
L13 | 866n
L14 | 738n
Q1 | PN2222A
Q2 | PN2222A
Q3 | PN2222A
Q4 | PN2222A
Q5 | PN2222A
Q6 | PN2222A
Q7 | PN2222A
Q8 | 2N7000
Q9 | J310
Q10 | PN2222A
Q11 | PN2222A
Q12 | PN2222A
Q13 | PN2222A
Q14 | PN2222A
Q15 | 2N7000
Q16 | 2N7000
Q17 | PN2222A
Q18 | PN2222A
Q19 | PN2222A
Q20 | 2N4401
Q21 | 2N4403
Q22 | 2N5109
Q23 | 2SC5739
Q24 | 2N4403
Q25 | 2N4403
Q26 | PN2222A
R1 | 2.2k
R2 | 10k
R3 | 100k
R4 | 10k
R5 | 4.7k
R6 | 100
R7 | 470
R8 | 100
R9 | 51
R10 | 300
R11 | 18
R12 | 300
R13 | 100k
R14 | 10k
R15 | 4.7k
R16 | 100
R17 | 470
R18 | 100
R19 | 51
R20 | 100
R21 | 68
R22 | 100
R23 | 1.5k
R24 | 2.2k
R25 | 2.2k
R26 | 220
R27 | 100
R28 | 4.7
R29 | 1k
R30 | 2.2k
R31 | 1k
R32 | 220
R33 | 100
R34 | 10
R35 | 100
R36 | 22k
R37 | 22k
R38 | 100k
R39 | 4.7k
R40 | 10k
R41 | 4.7k
R42 | 100k
R43 | 100
R44 | 100
R45 | 100
R46 | 51
R47 | 3.3k
R48 | 2.2k
R49 | 100k
R50 | 10k
R51 | 10k
R52 | 4.7k
R53 | 4.7k
R54 | 100
R55 | 4.7k
R56 | 4.7k
R57 | 4.7k
R58 | 100
R59 | 4.7k
R60 | 47k
R61 | 5.6k
R62 | 100
R63 | 3k
R64 | 300
R65 | 10k log
R66 | 100k
R67 | 100k
R68 | 150k
R69 | 22k
R70 | 10k
R71 | 1.5k
R72 | 470
R73 | 100
R74 | 1
R75 | 1
R76 | 200
R77 | 2.2k
R78 | 680
R79 | 33
R80 | 48
R81 | 12
R82 | 18
R83 | 2.2k
R84 | 2.2k
R85 | 10k
R86 | 10k
R87 | 220
R88 | 3.3k
R89 | 3k
R90 | 560
R91 | 3.3k
R92 | 100k
T1 | FT37-43 10T trifilar
T2 | FT37-43 10T bifilar
T3 | FT37-43 10T bifilar
T4 | FT37-43
T4 | FT37-43 10T bifilar
T5 | FT37-43 10T trifilar
T6 | FT37-43 10T trifilar
T7 | FT37-43 10T bifilar
T8 | FT37-43 10T bifilar
T9 | BN43-302 5T bifilar
VR1 | 78L08
X1 | 4.000 MHz
X2 | 18.000 MHz
