NT7S/WillametteTransceiver/qrp-l Group Project Kitting Worksheet.ods

Sheet: Parts Acq
Part | No. per kit | Total No. | Price Break | Price per | Total Price | Source | Part No. | Ordered | No. of kits | 20
10n cap | 8 | 160 | 200 | $0.05 | $10.34 | Digi-Key | BC1158CT-ND | TRUE | Total cost | $659.07
PN2222A | 16 | 320 | 500 | $0.03 | $14.73 | Digi-Key | PN2222AFS-ND | TRUE | Cost per kit | $32.95
2N7000 | 3 | 60 | 100 | $0.14 | $13.52 | Digi-Key | 2N7000FS-ND | TRUE
MV209 | 2 | 40 | 40 | $0.31 | $12.34 | Digi-Key | MV209OS-ND | TRUE
1N4148 | 17 | 340 | 500 | $0.01 | $5.43 | Digi-Key | 1N4148FS-ND | TRUE
2N4403 | 3 | 60 | 100 | $0.07 | $6.83 | Digi-Key | 2N4403-ND | TRUE
2SC5739 | 1 | 20 | 20 | $0.77 | $15.30 | Digi-Key | 2SC57390P-ND | TRUE
J310 | 1 | 20 | 25 | $0.31 | $7.81 | Digi-Key | J310-ND | TRUE
78L08 | 1 | 20 | 25 | $0.29 | $7.22 | Digi-Key | MC78L08ACP-ND | TRUE
2N4401 | 1 | 20 | 100 | $0.06 | $6.44 | Digi-Key | 2N4401-ND | TRUE
100n cap | 31 | 620 | 1000 | $0.03 | $33.08 | Digi-Key | BC1160CT-ND | TRUE
45 trim cap | 6 | 120 | 120 | $0.30 | $35.87 | Digi-Key | 490-1953-ND | TRUE
18 cap | 5 | 100 | 100 | $0.08 | $8.00 | Diz | 140-50N2-180J | TRUE
T50-2 | 1 | 20 | 25 | $0.20 | $5.00 | Diz |  | TRUE
FT50-43 | 1 | 20 | 25 | $0.28 | $7.00 | Diz |  | TRUE
FT37-43 | 10 | 200 | 300 | $0.15 | $45.00 | Diz |  | TRUE
T37-6 | 10 | 200 | 300 | $0.14 | $42.00 | Diz |  | TRUE
33 NP0 cap | 1 | 20 | 25 | $0.08 | $2.00 | Diz | 140-50N5-330J | TRUE
22 cap | 6 | 120 | 125 | $0.08 | $10.00 | Diz | 140-50N2-220J | TRUE
BN43-302 | 1 | 20 | 20 | $0.50 | $10.00 | Diz |  | TRUE
100 cap | 4 | 80 | 100 | $0.10 | $10.00 | Diz | 140-50N5-101J | TRUE
180 cap | 2 | 40 | 50 | $0.12 | $6.00 | Diz | 140-50N5-181J | TRUE
270 NP0 cap | 1 | 20 | 25 | $0.16 | $4.00 | Diz | 140-50N5-271J | TRUE
220 cap | 1 | 20 | 25 | $0.16 | $4.00 | Diz | 140-50N5-221J | TRUE
2.2 cap | 2 | 40 | 50 | $0.08 | $4.00 | Diz | 140-50N2-2R2C | TRUE
2N5109 | 1 | 20 | 20 | $2.00 | $40.00 | Diz |  | TRUE
22 NP0 cap | 1 | 20 | 25 | $0.08 | $2.00 | Diz | 140-50N2-220J | TRUE
15 NP0 cap | 1 | 20 | 25 | $0.08 | $2.00 | Diz | 140-50N5-150J
3x4 cu clad | 1 | 20 | 20 | $1.00 | $20.00 | Elec. Gold. | G2622
5x10 cu clad | 1 | 20 | 20 | $1.40 | $28.00 | Elec. Gold. | G2632 | TRUE
47k res | 1 | 20 | 100 | $0.01 | $1.00 | Jameco |  | TRUE
150k res | 1 | 20 | 100 | $0.01 | $1.00 | Jameco |  | TRUE
10k log pot | 1 | 20 | 20 | $1.09 | $21.80 | Jameco | 255425 | TRUE
3k res | 2 | 40 | 100 | $0.01 | $1.00 | Jameco |  | TRUE
5.6k res | 1 | 20 | 100 | $0.01 | $1.00 | Jameco |  | TRUE
3.3k res | 3 | 60 | 100 | $0.01 | $1.00 | Jameco |  | TRUE
10 res | 1 | 20 | 100 | $0.01 | $1.00 | Jameco |  | TRUE
10k res | 7 | 140 | 200 | $0.01 | $2.00 | Jameco |  | TRUE
10k CD pot | 1 | 20 | 20 | $1.30 | $26.00 | Jameco | 286388 | TRUE
22k res | 1 | 20 | 100 | $0.01 | $1.00 | Jameco |  | TRUE
RG174 1' | 1 | 20 | 20 | $0.95 | $19.00 | Jameco | 644818 | TRUE
4 MHz CR | 1 | 20 | 20 | $0.26 | $5.10 | Digi-Key | 445-1642-ND | TRUE
560 res | 1 | 20 | 100 | $0.01 | $1.00 | Jameco |  | TRUE
BNC plug | 1 | 20 | 20 | $1.38 | $27.60 | Jameco | 355215 | TRUE
18 MHz xtal | 1 | 20 | 20 | $0.30 | $5.98 | Digi-Key | X144-ND | TRUE
12 res | 1 | 20 | 100 | $0.01 | $1.00 | Jameco |  | TRUE
680 res | 1 | 20 | 100 | $0.01 | $1.00 | Jameco |  | TRUE
1 res | 2 | 40 | 100 | $0.01 | $1.00 | Jameco |  | TRUE
47 res | 1 | 20 | 100 | $0.01 | $1.00 | Jameco |  | TRUE
33 res | 1 | 20 | 100 | $0.01 | $1.00 | Jameco |  | TRUE
4.7k res | 10 | 200 | 200 | $0.01 | $2.00 | Jameco |  | TRUE
100 res | 16 | 320 | 400 | $0.01 | $4.00 | Jameco |  | TRUE
470 res | 3 | 60 | 100 | $0.01 | $1.00 | Jameco |  | TRUE
BNC | 1 | 20 | 25 | $1.43 | $35.75 | Jameco | 112424 | TRUE
2.2k res | 8 | 160 | 200 | $0.01 | $2.00 | Jameco |  | TRUE
10k pot | 1 | 20 | 20 | $1.13 | $22.60 | Jameco | 286273 | TRUE
100k res | 8 | 160 | 200 | $0.01 | $2.00 | Jameco |  | TRUE
1k res | 2 | 40 | 100 | $0.01 | $1.00 | Jameco |  | TRUE
1.5k res | 2 | 40 | 100 | $0.01 | $1.00 | Jameco |  | TRUE
68 res | 1 | 20 | 100 | $0.01 | $1.00 | Jameco |  | TRUE
4.7 res | 1 | 20 | 100 | $0.01 | $1.00 | Jameco |  | TRUE
18 res | 2 | 40 | 100 | $0.01 | $1.00 | Jameco |  | TRUE
300 res | 3 | 60 | 100 | $0.01 | $1.00 | Jameco |  | TRUE
220 res | 3 | 60 | 100 | $0.01 | $1.00 | Jameco |  | TRUE
51 res | 5 | 100 | 100 | $0.01 | $1.00 | Jameco |  | TRUE
390 cap | 2 | 40 | 40 | $0.08 | $3.04 | Digi-Key | BC1020CT-ND | TRUE
470 NP0 cap | 3 | 60 | 100 | $0.20 | $20.30 | Digi-Key | BC1046CT-ND | TRUE
1u cap | 4 | 80 | 100 | $0.03 | $3.20 | Digi-Key | 493-1333-ND | TRUE
200 trim pot | 1 | 20 | 20 | $0.04 | $0.80 | NT7S
220u cap | 3 | 60 | 100 | $0.04 | $4.00 | NT7S
10u cap | 8 | 160 | 200 | $0.04 | $8.00 | NT7S
100u cap | 2 | 40 | 100 | $0.04 | $4.00 | NT7S
ft cap | 2
30 ga m. wire |  |  |  |  |  |  |  | TRUE
26 ga m. wire |  |  |  |  |  |  |  | TRUE
hookup wire |  |  |  |  |  |  |  | TRUE

Sheet: Leads
Call | Name | E-mail
W8FG | Seth Lavinder | w8fgqrp2@gmail.com
W9QS | Mike Broga | w9qs@yahoo.com
AJ4AY | Jay Bromley | aj4ay@comcast.net
N0NBD | Paul Smith | psmith61@cox.net
WB8ICN | Mike Hall | wb8icn@comcast.net
K5EST | Walter Dufrain | walter.k5est@gmail.com
K9UT | Jerry Uhte | K9ut@aol.com
WB6TNL | Steve Smith | sigcom@juno.com
WA7DUY | Jim Pruitt | wa7duy@charter.net
KF4LMZ | Patrick York | pyork@cetlink.net
KA5OAI | Sam Morgan | ka5oai@jass-ltd.org
KC7FYS | Jonathan Haynes | kc7fys@yahoo.com
W8WEB | Eric | w8web@columbus.rr.com

Sheet: Purchasers
Shipped | Call | Name | Address | Address 2 | City | State | Postal Code | Country | E-mail | Qty | Paid Date | Pay Method | Shipping | Customs Code
x | W8FG | Seth Lavinder | 22 Warren Place |  | Charleston | WV | 25302 | USA | w8fgqrp2@gmail.com | 1 | 12/20/07 | PayPal
x | W2CTX | Ronald Pfeiffer | 784 Franklin Street |  | Worcester | MA | 01604 | USA | w2ctx@yahoo.com | 1 | 12/27/07 | PayPal
x |  | Chris Howard | 1707 Remington St. |  | Fort Collins | CO | 80525 | USA | chris@yipyap.com | 1 | 12/27/07 | PayPal
x | KB9BVN | Brian Murrey | 47 Grassy Dr. |  | New Whiteland | IN | 46184 | USA | kb9bvn@gmail.com | 1 | 12/27/07 | PayPal
x | G4GXL | Steve Fletcher | 43 Philip Rudd Court | Pott Row | Kings Lynn, Norfolk |  | PE32 1WA | United Kingdom | steve@g4gxl.com | 1 | 12/27/07 | PayPal | First-Class Mail International | Transceiver apparatus for radio-telegraphy | Commodity Code No 8525209900
x | N1RX | Bruce Beford | 178 Summer St. |  | Newport | NH | 03773 | USA | bruce.beford@verizon.net | 1 | 12/28/07 | PayPal
x | VE3TIX | Michael Taylor | 7 Highside Road | RR#2 | Trenton | Ontario | K8V 5P5 | Canada | mctylr@gmail.com | 1 | 12/28/07 | PayPal | Priority Mail International
x | WB8ICN | Michael Hall | 6116 South Jackson Road |  | Jackson | MI | 49201 | USA | wb8icn@comcast.net | 1 | 12/28/07 | PayPal
x | N1FIY | Brian Arsenault | 900 Whittemore St. |  | Leicester | MA | 01524 | USA | bgaphoto@gmail.com | 1 | 12/29/07 | PayPal
x | WA6L | John Graf | 23085 Old Ranch Rd |  | Alpine | CA | 91901-2505 | USA | jmgraf@mac.com | 1 | 01/09/08 | PayPal
x | K6WV | Jon Kelley | 10571 Stokes Ave |  | Cupertino | CA | 95014 | USA | 99kelly@comcast.net | 1 | 01/09/08 | PayPal
x | KD2MU | Louis Visconti | 2 Miller Court |  | Miller Place | NY | 11764 | USA | lviscont@verizon.net | 1 | 01/12/08 | PayPal
x |  | Douglas Fredericks | 891 Fifth Avenue |  | Sacramento | CA | 95818 | USA | douglasfredericks@comcast.net | 1 | 01/14/08 | PayPal
x | KB3KPV | Kenneth DeLucca | 125 E Charlotte St. |  | Millersville | PA | 17551 | USA | kenneth.delucca@millersville.edu | 1 | 01/18/08 | MO
x | W8BH | Bruce Hall | 1800 Southwood Ln W |  | Dayton | OH | 45419 | USA | brucehall@ameritech.net | 1 | 01/18/08 | PayPal
x | KC0ZLR | Ed Comfort | 19401 E. Navarro Drive |  | Aurora | CO | 80013 | USA | edcomfort@comcast.net | 1 | 01/21/08 | PayPal
x | VE3NOO | Michael Bell | 221A Richmond St | RR 1 | Bath | Ontario | K0H 1G0 | Canada | pmbell@mac.com | 1 | 01/23/08 | PayPal | First-Class Mail International
x | N6TUX | Tucker Gary | 4389 Starthmore Drive |  | Redding | CA | 96002-3852 | USA | radiotucker@gmail.com | 1 | 01/30/08 | PayPal
x | VE5JRP | JR Prince | P.O. Box 1-6 |  | Claybank | Saskatchewan | S0H 0W0 | Canada | prince200@sasktel.net | 1 | 01/31/08 | PayPal | First-Class Mail International
x | WB9VTB | Dave Goodrich | 3300 N. 100 W. |  | Greenfield | IN | 46140 | USA | yellowhousejake@pixelhammer.com | 1 | 02/04/08 | PayPal
x | W1RT | John D'Ausilio | 124 Mile Common Rd. |  | Easton | CT | 06612 | USA | jdausilio@gmail.com | 1 | 02/07/08 | PayPal

Sheet: Packing List
Packed | Part | Qty
 | 100n (marked 104) | 31
 | 470 NP0 (marked 471) | 3
 | 270 NP0 (marked 271) | 1
 | 18 | 4
 | 22 | 6
 | 45 trimmer | 6
 | 100 (marked 101) | 4
 | 2.2 | 2
 | 15 NP0 | 1
 | 33 NP0 | 1
 | 220 (marked 221) | 1
 | 47 NP0 | 1
 | 1u | 4
 | 220u | 3
 | 22u | 2
 | 10n (marked 103) | 8
 | 10u | 6
 | 100u | 1
 | 180 (marked 181) (100 WVDC) | 2
 | 390 (marked 391) (100 WVDC) | 2
 | MV209 | 2
 | 1N4148 | 17
 | 5.6u molded | 1
 | FT37-43 | 10
 | T37-6 | 10
 | FT50-43 | 1
 | T50-2 | 1
 | BN43-302 | 1
 | PN2222A | 16
 | 2N7000 | 3
 | J310 | 1
 | 2N4401 | 1
 | 2N4403 | 3
 | 2N5109 | 1
 | 2SC5739 | 1
 | 3.3k (orange-orange-red) | 4
 | 10k lin pot | 1
 | 100k (brown-black-yellow) | 8
 | 10k (brown-black-orange) | 7
 | 4.7k (yellow-violet-red) | 8
 | 100 (brown-black-brown) | 18
 | 470 (yellow-violet-brown) | 3
 | 51 (green-brown-black) | 3
 | 300 (orange-black-brown) | 3
 | 18 (brown-gray-black) | 2
 | 68 (blue-gray-black) | 1
 | 1.5k (brown-green-red) | 2
 | 2.2k (red-red-red) | 7
 | 220 (red-red-brown) | 3
 | 4.7 (yellow-violet-gold) | 1
 | 1k (brown-black-red) | 2
 | 10 (brown-black-black) | 1
 | 10k center detent pot | 1
 | 47k (yellow-violet-orange) | 1
 | 5.6k (green-blue-red) | 1
 | 3k (orange-black-red) | 2
 | 10k log pot | 1
 | 150k (brown-green-yellow) | 1
 | 22k (red-red-orange) | 1
 | 1 (brown-black-gold) | 2
 | 200 trim pot | 1
 | 5k trim pot | 1
 | 680 (blue-gray-brown) | 1
 | 33 (orange-orange-black) | 1
 | 47 (yellow-violet-black) | 1
 | 12 (brown-red-black) | 1
 | 18 (brown-gray-black) | 1
 | 560 (green-blue-brown) | 1
 | 78L08 | 1
 | 4.000 MHz ceramic resonator | 1
 | 18.000 MHz crystal | 1
 | Feedthrough Cap | 2
 | Bifilar Wire | 10 ft
 | 26 ga magnet wire | 24 ft
 | RG-174 | 2 ft
 | Hookup wire | 4 ft
 | BNC jack | 1
 | BNC plug | 1
 | Manhattan Pads | 175
 | Copper Clad Substrate (VFO) | 1
 | Copper Clad Substrate (Mainboard) | 10 ft
 | Ribbon Wire | 8 in
