NT7S/WillametteTransceiver/qrp-l Group Project Mainboard Layout.pdf

## VFO In

+12v T

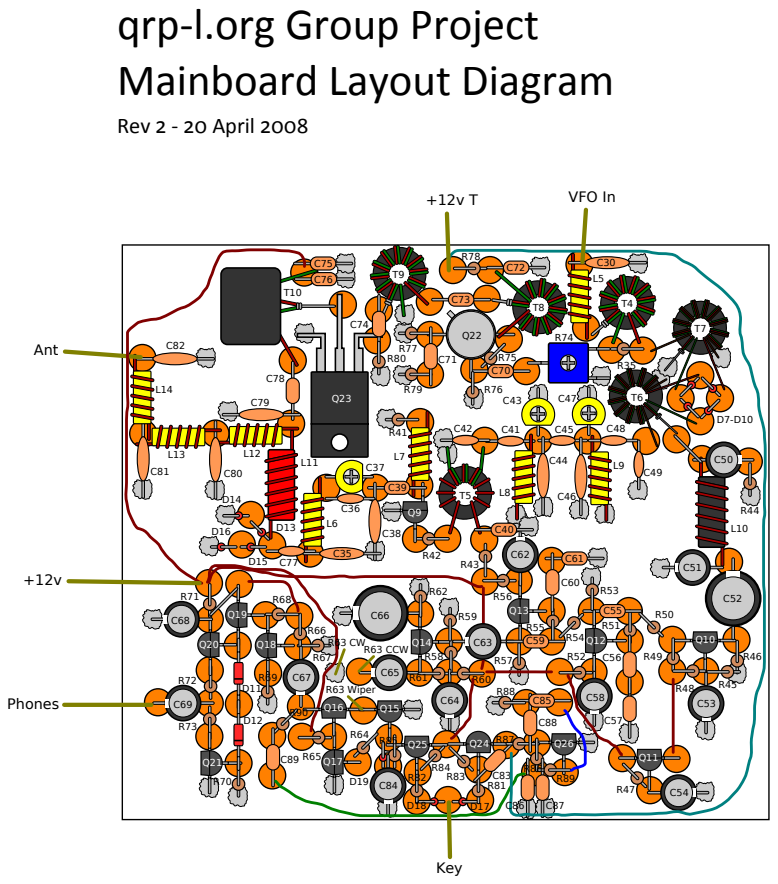
[picture p131: page 1]

qrp‐l.org Group Project
Mainboard Layout Diagram
