NT7S/WillametteTransceiver/qrp-l Group Project Schematic.pdf

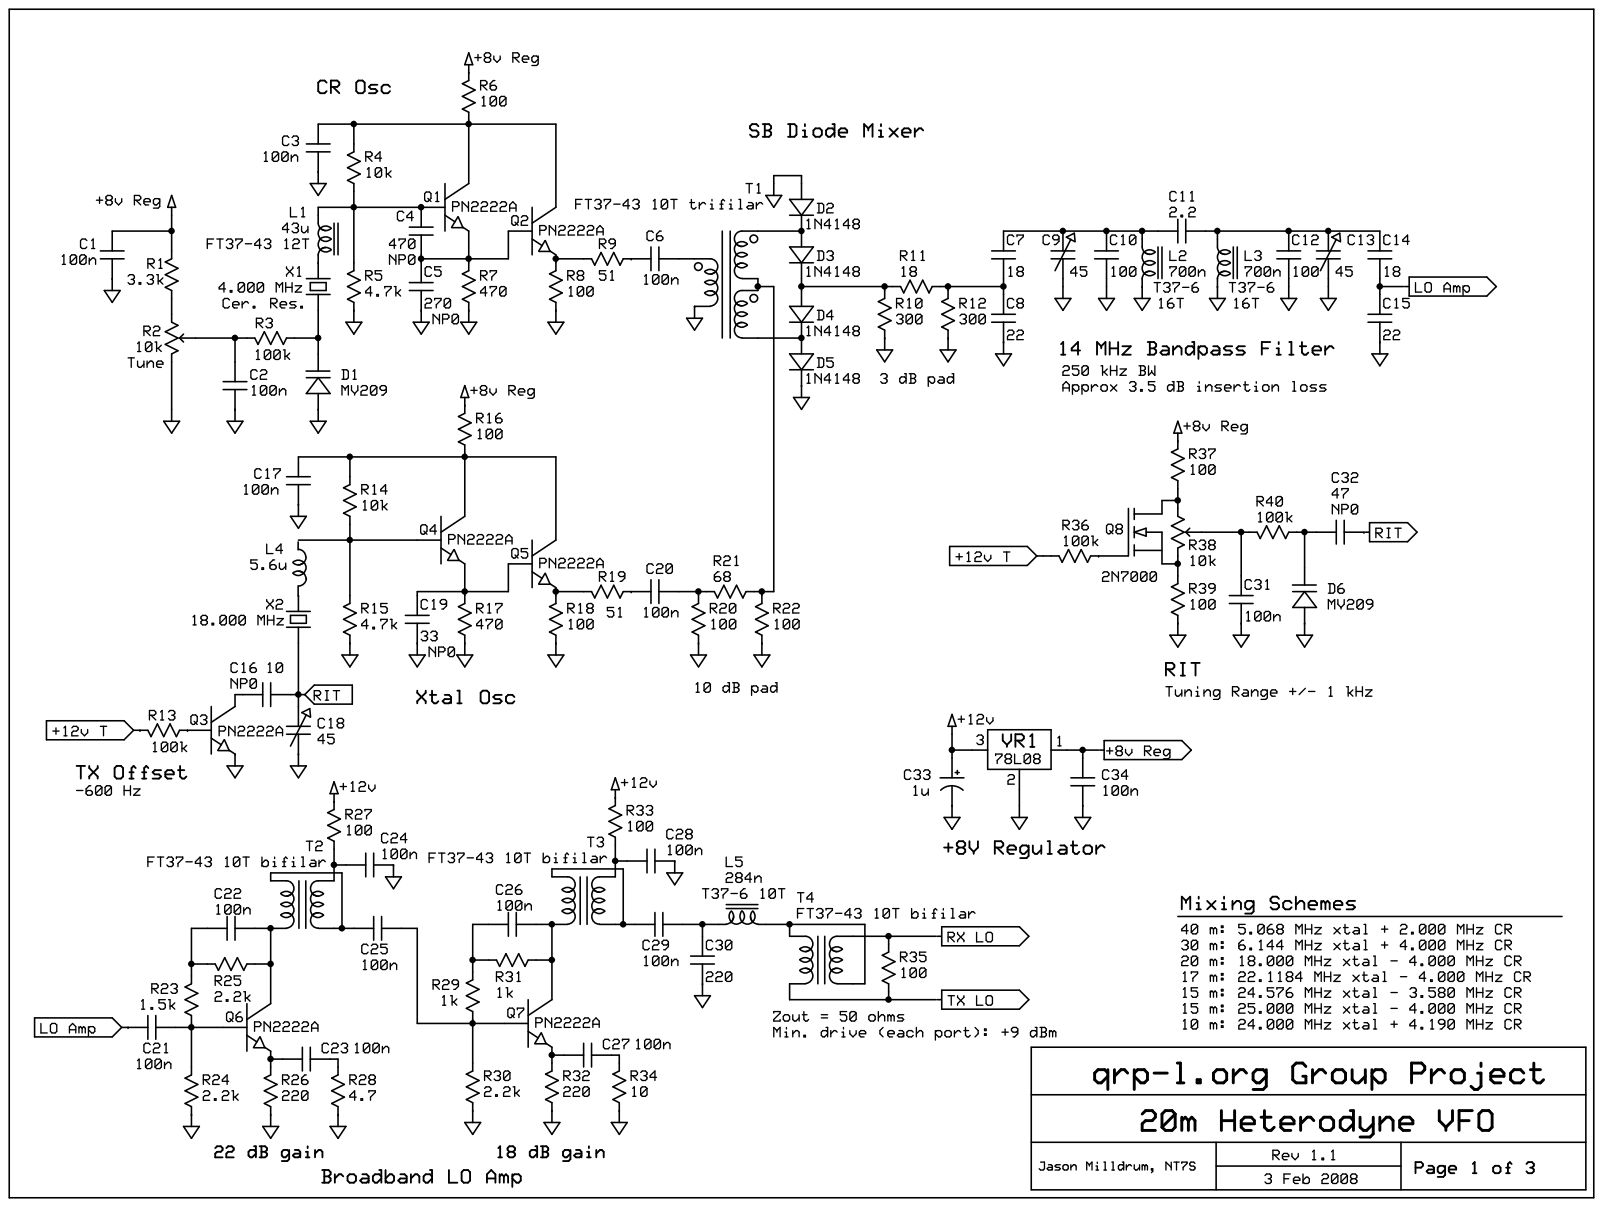
[picture p132: page 1]

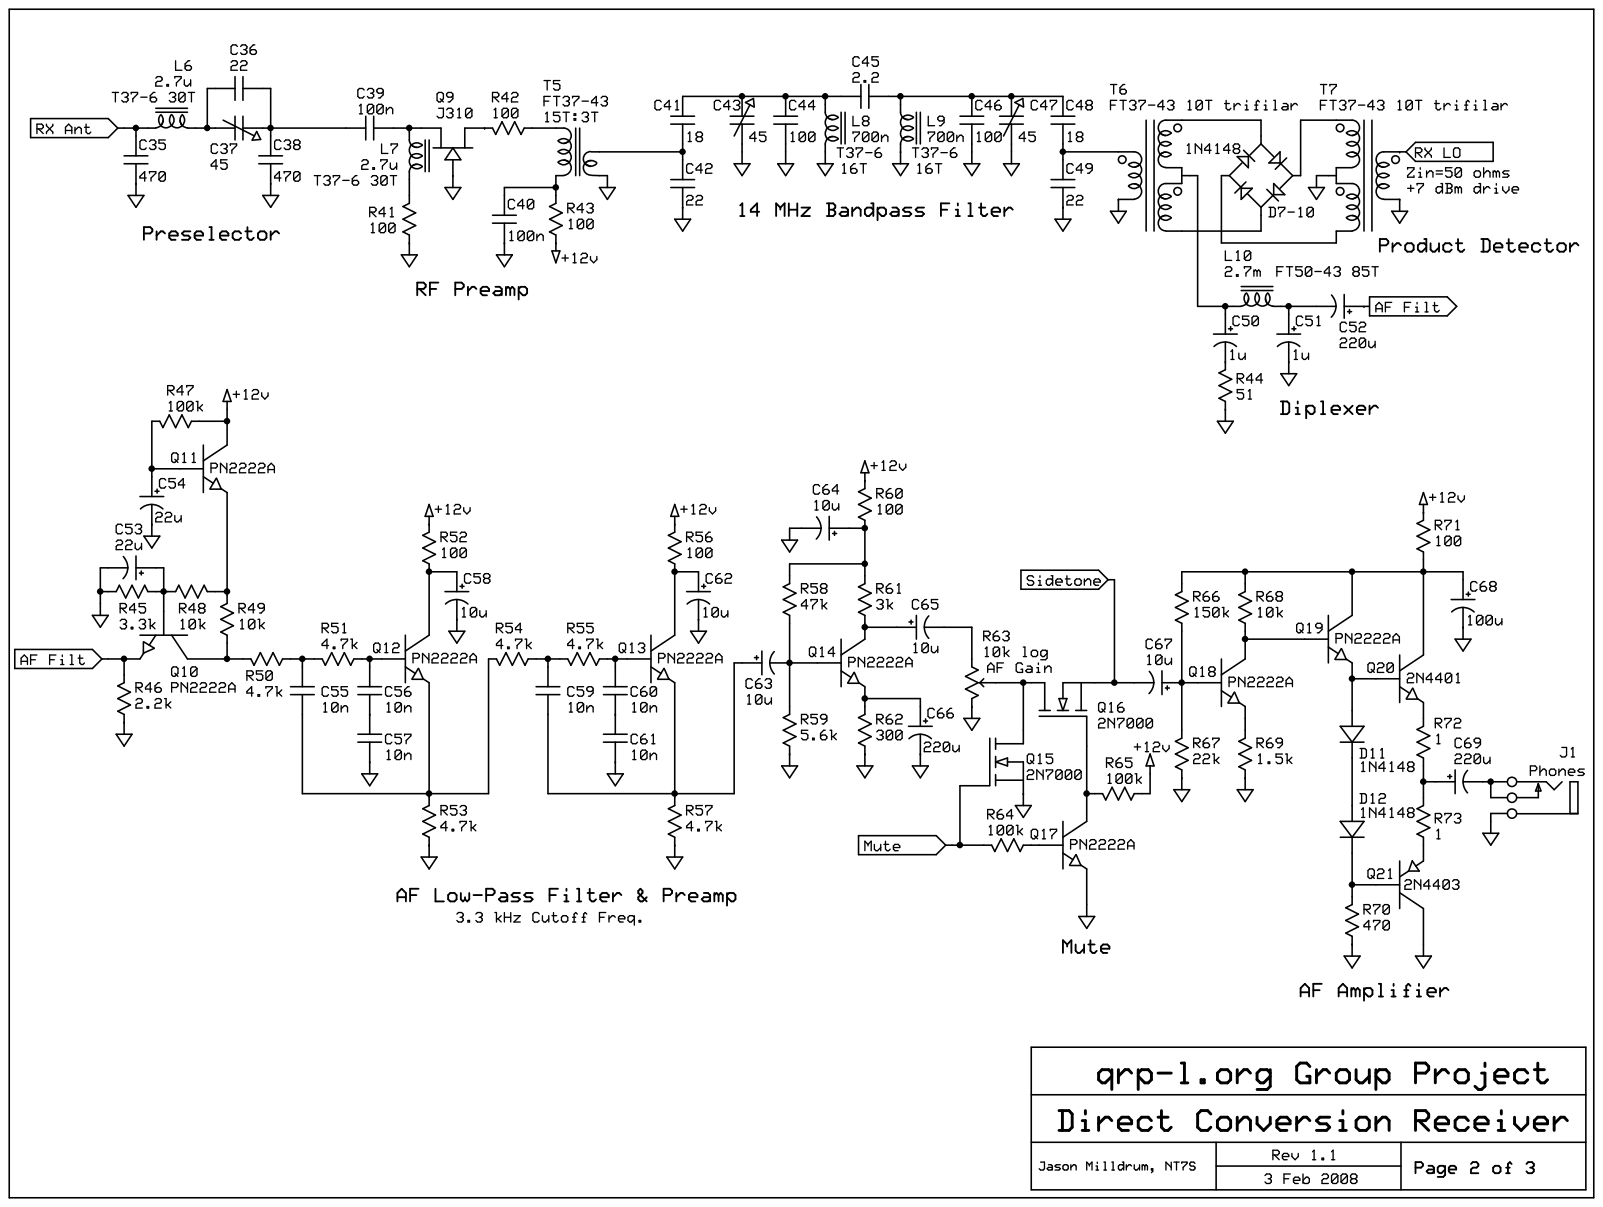
[picture p133: page 2]

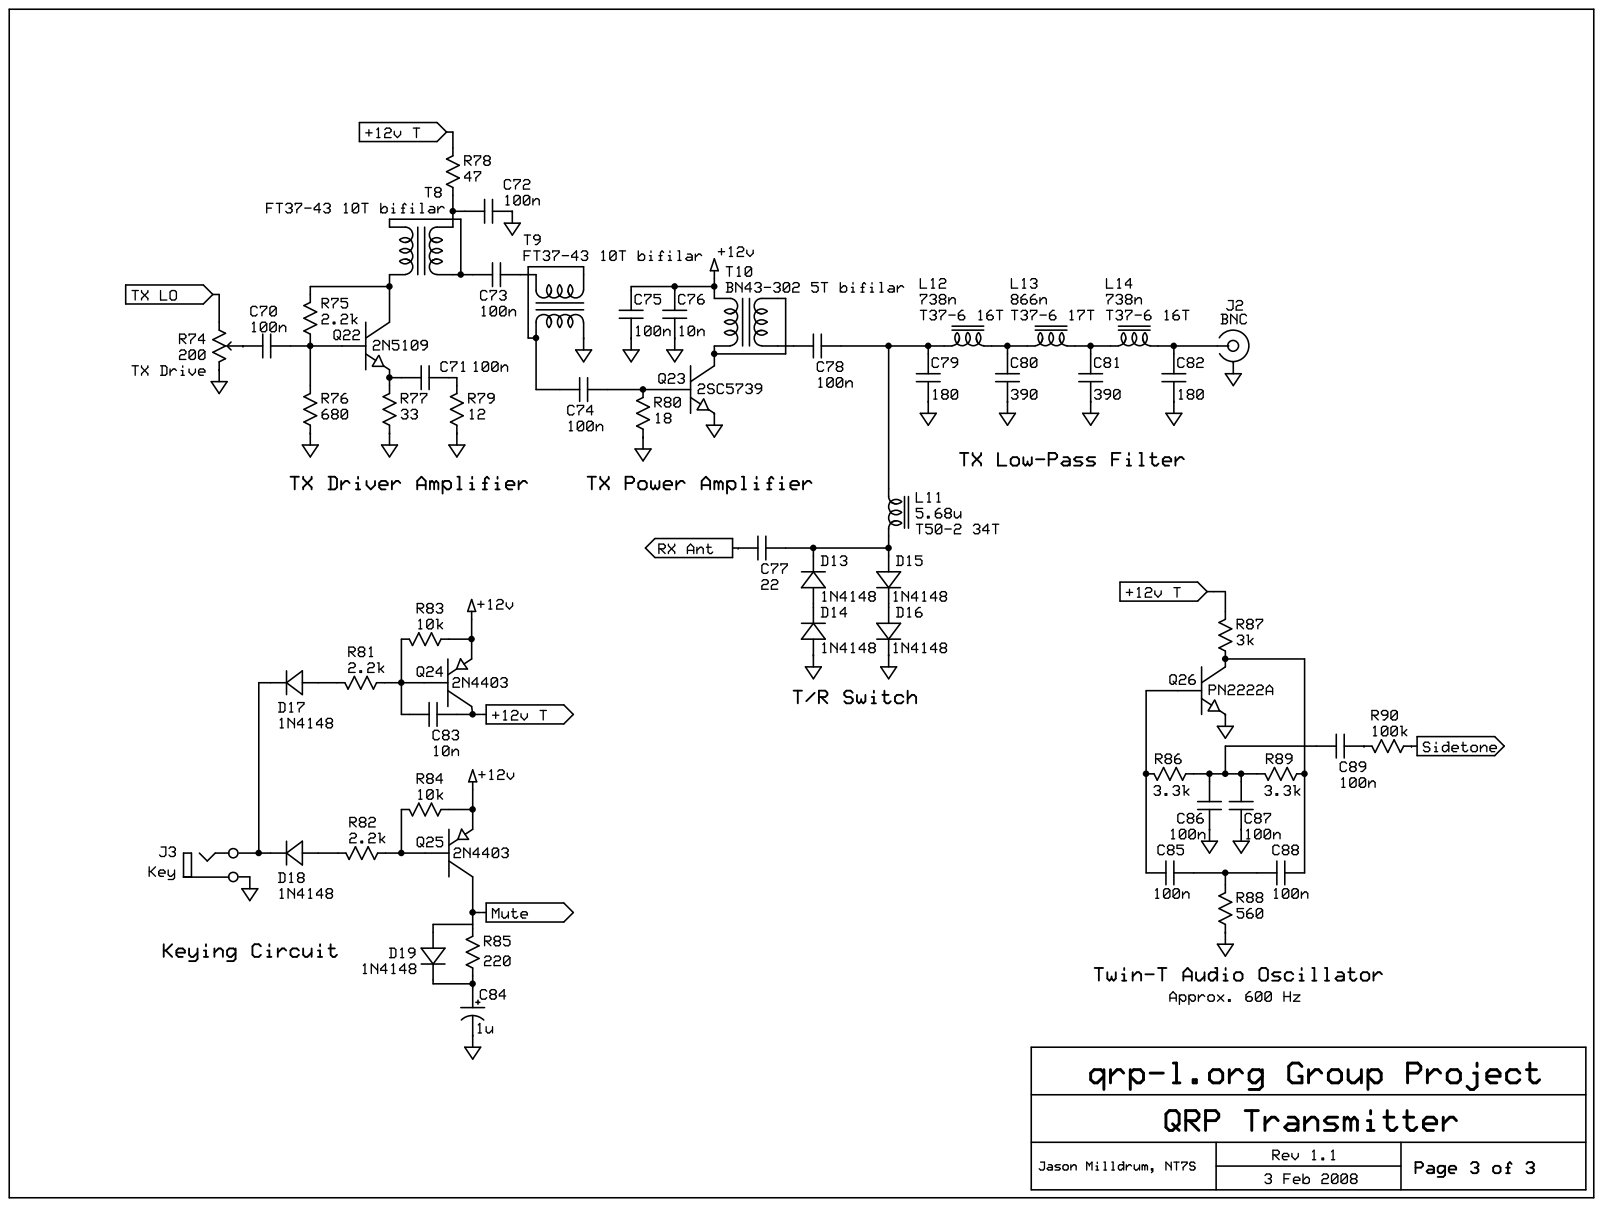
[picture p134: page 3]
