NT7S/WillametteTransceiver/qrp-l Group Project RF Probe.pdf

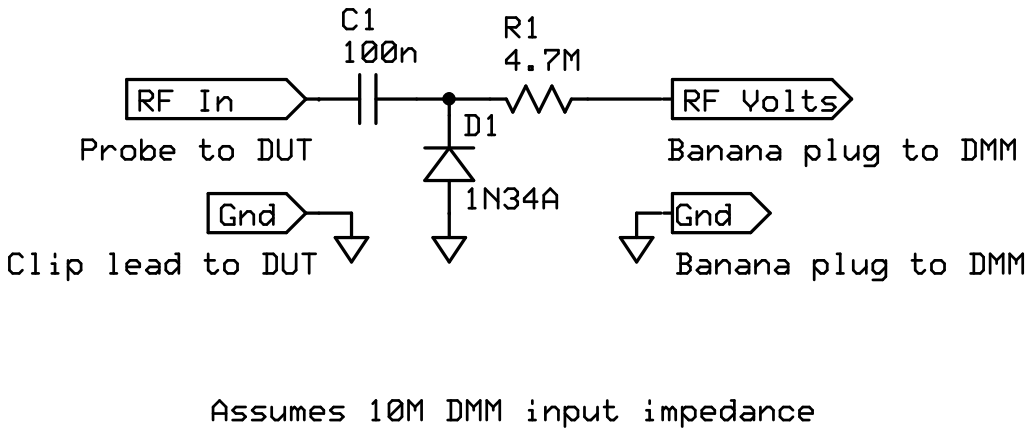
[picture p135: page 1]
