NT7S/WillametteTransceiver/qrp-l Group Project v11.pdf

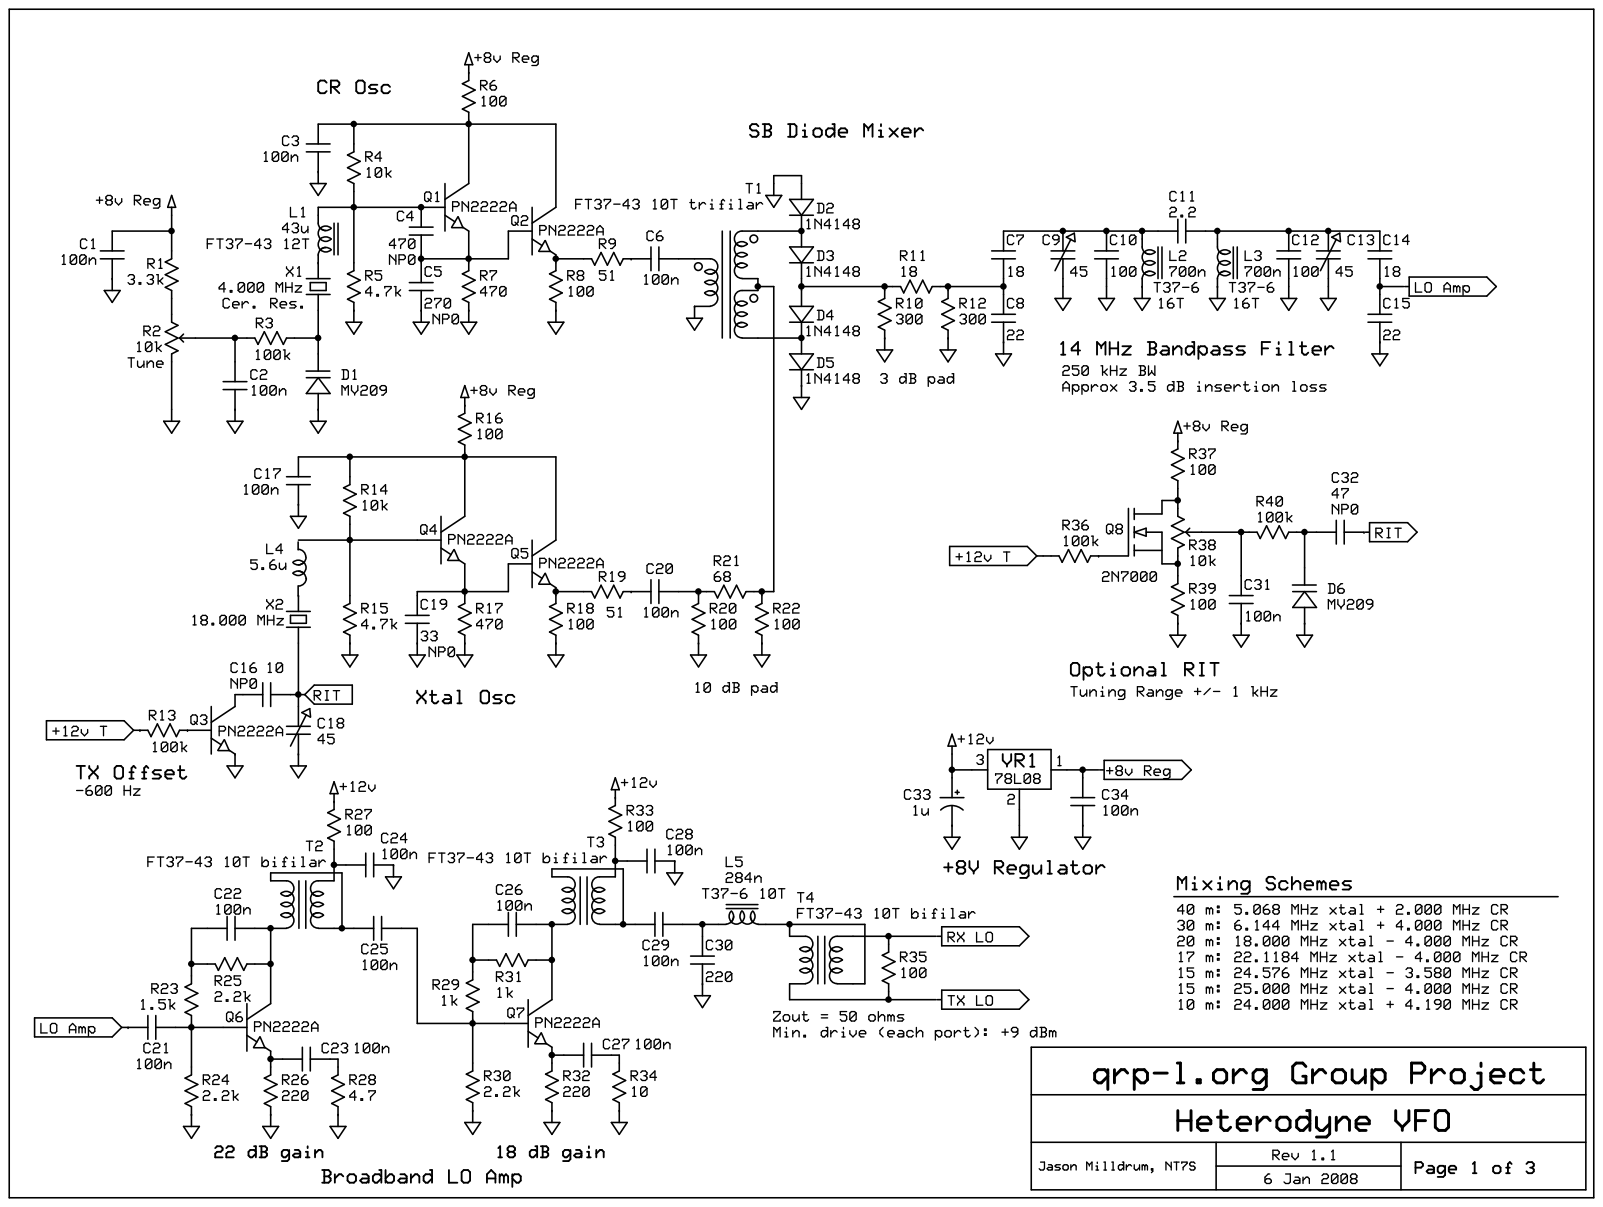
[picture p136: page 1]

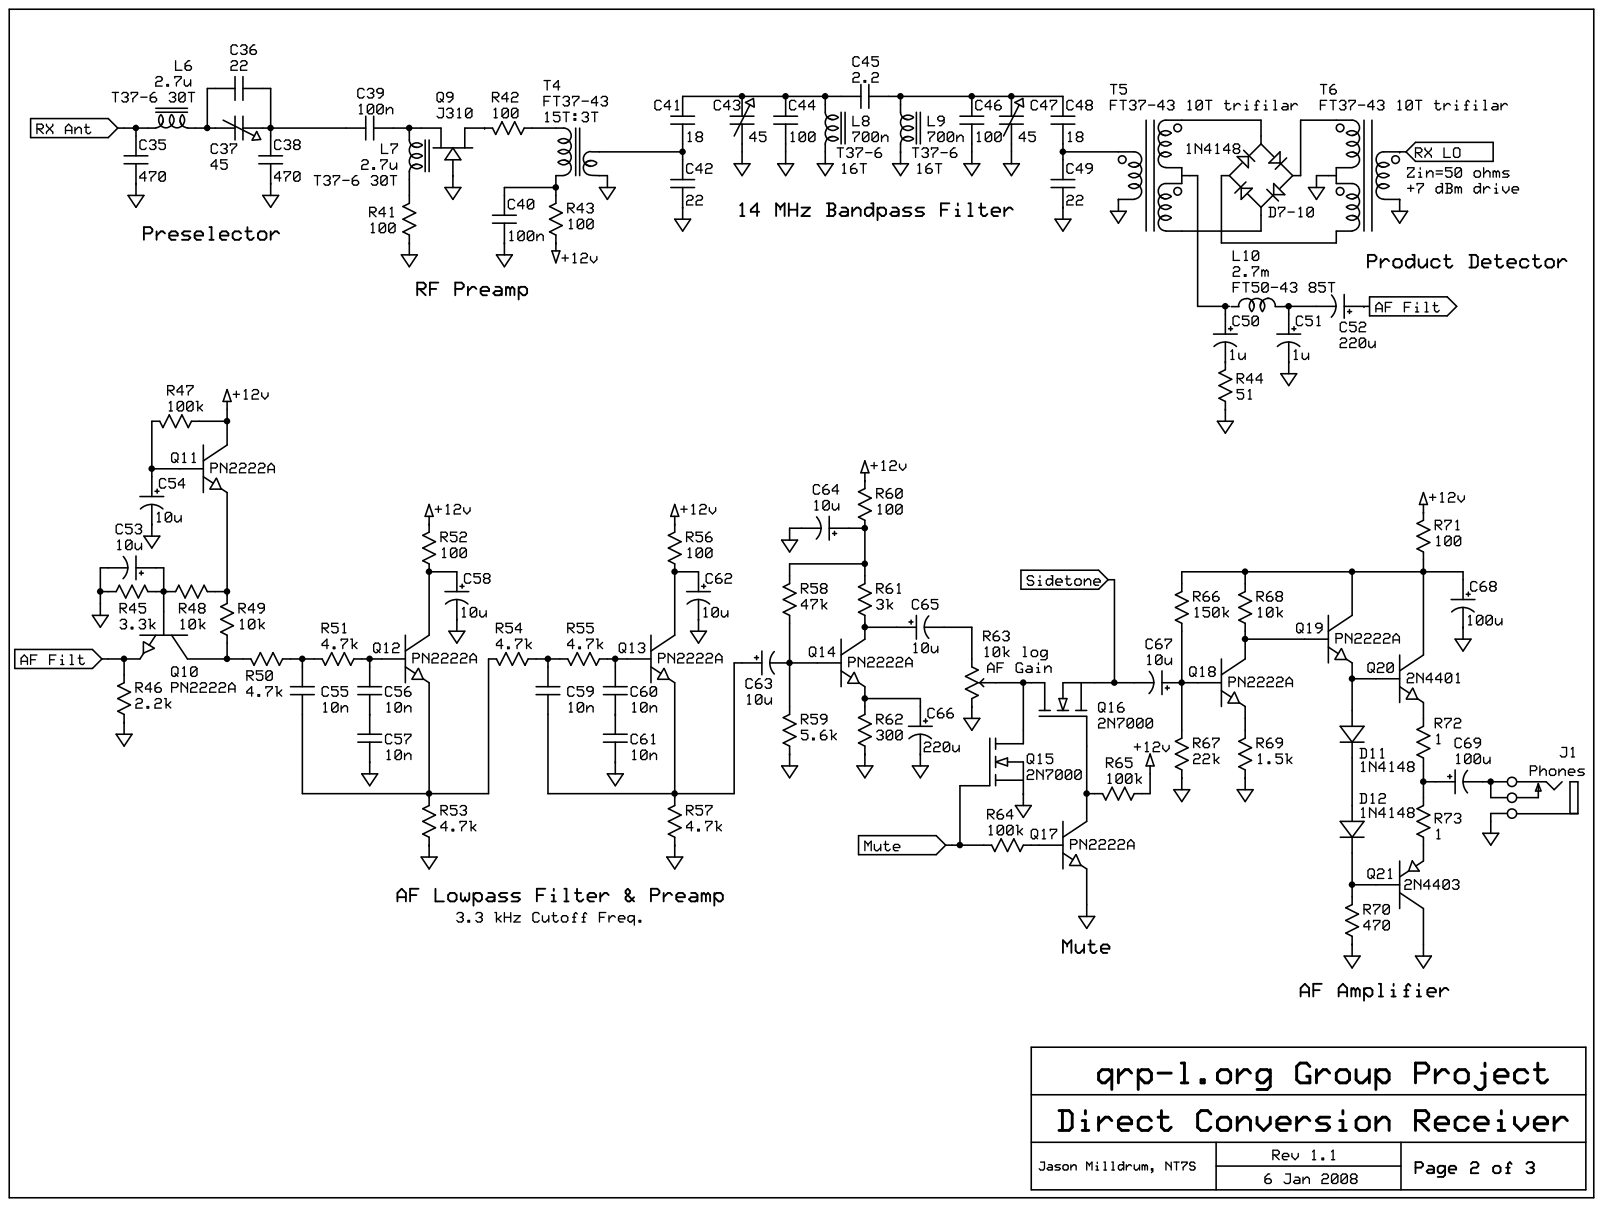
[picture p137: page 2]

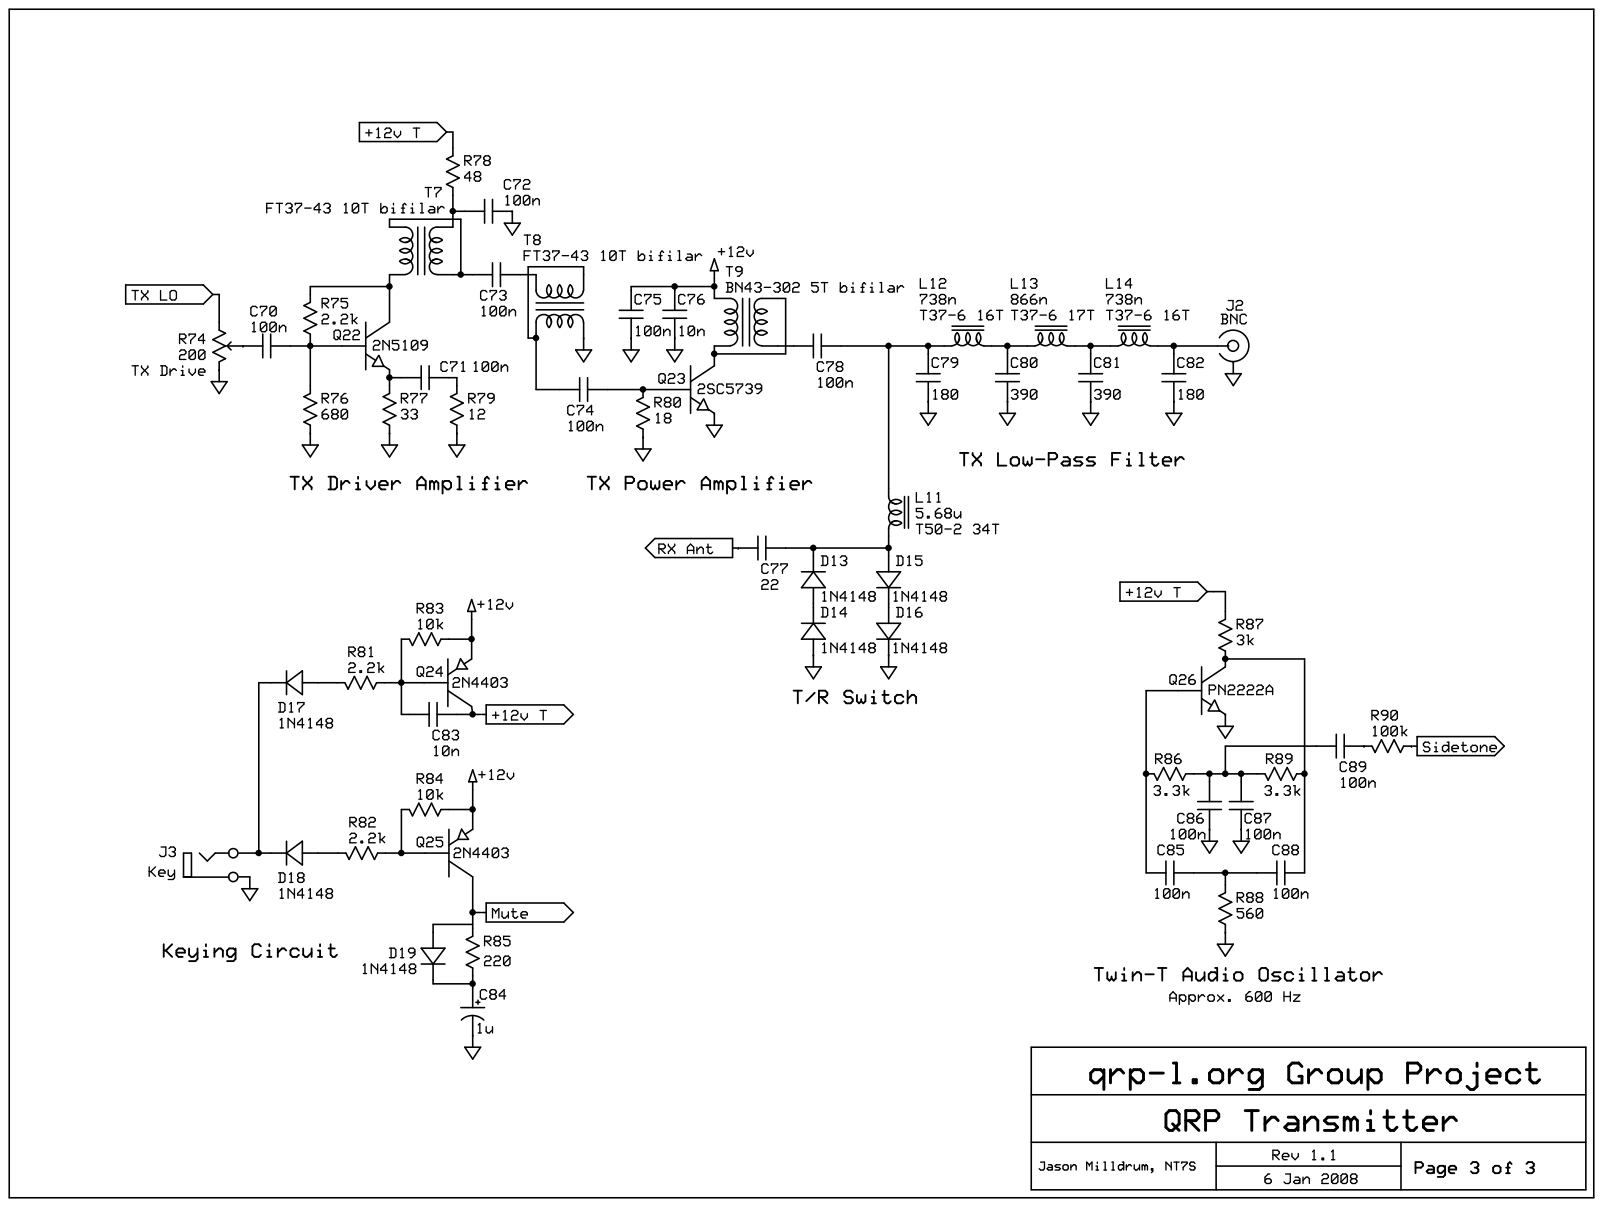
[picture p138: page 3]
