NT7S/WillametteTransceiver/qrp-l Group Project VFO Layout.pdf

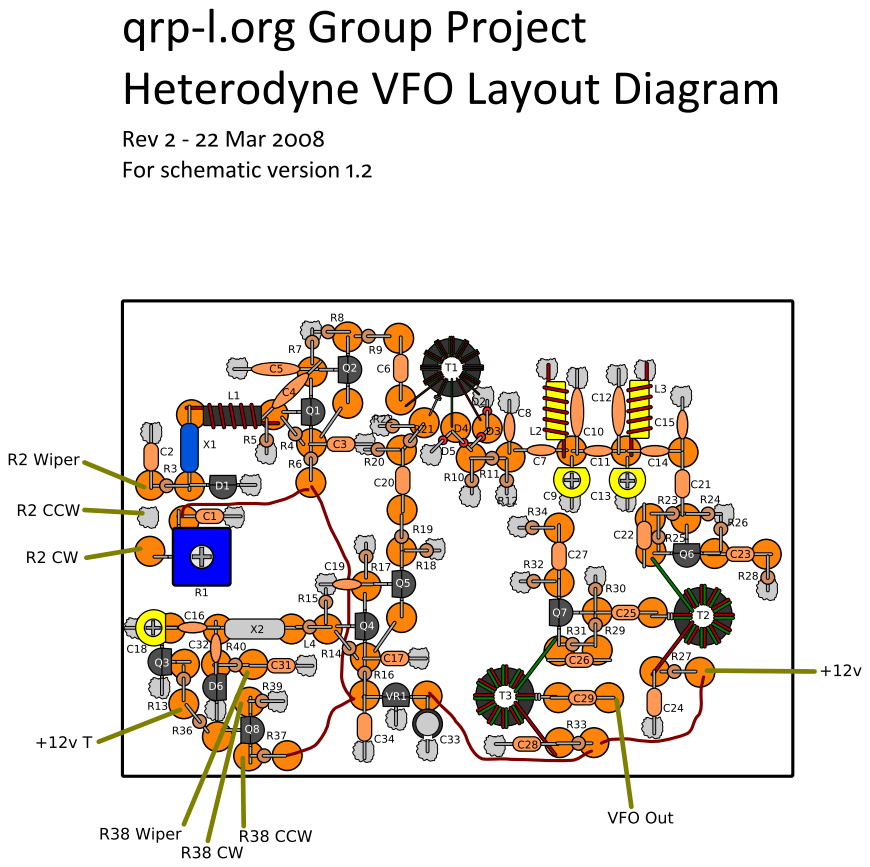
[picture p139: page 1]
