NT7S/WillametteTransceiver/qrp-l Group Project v1.pdf

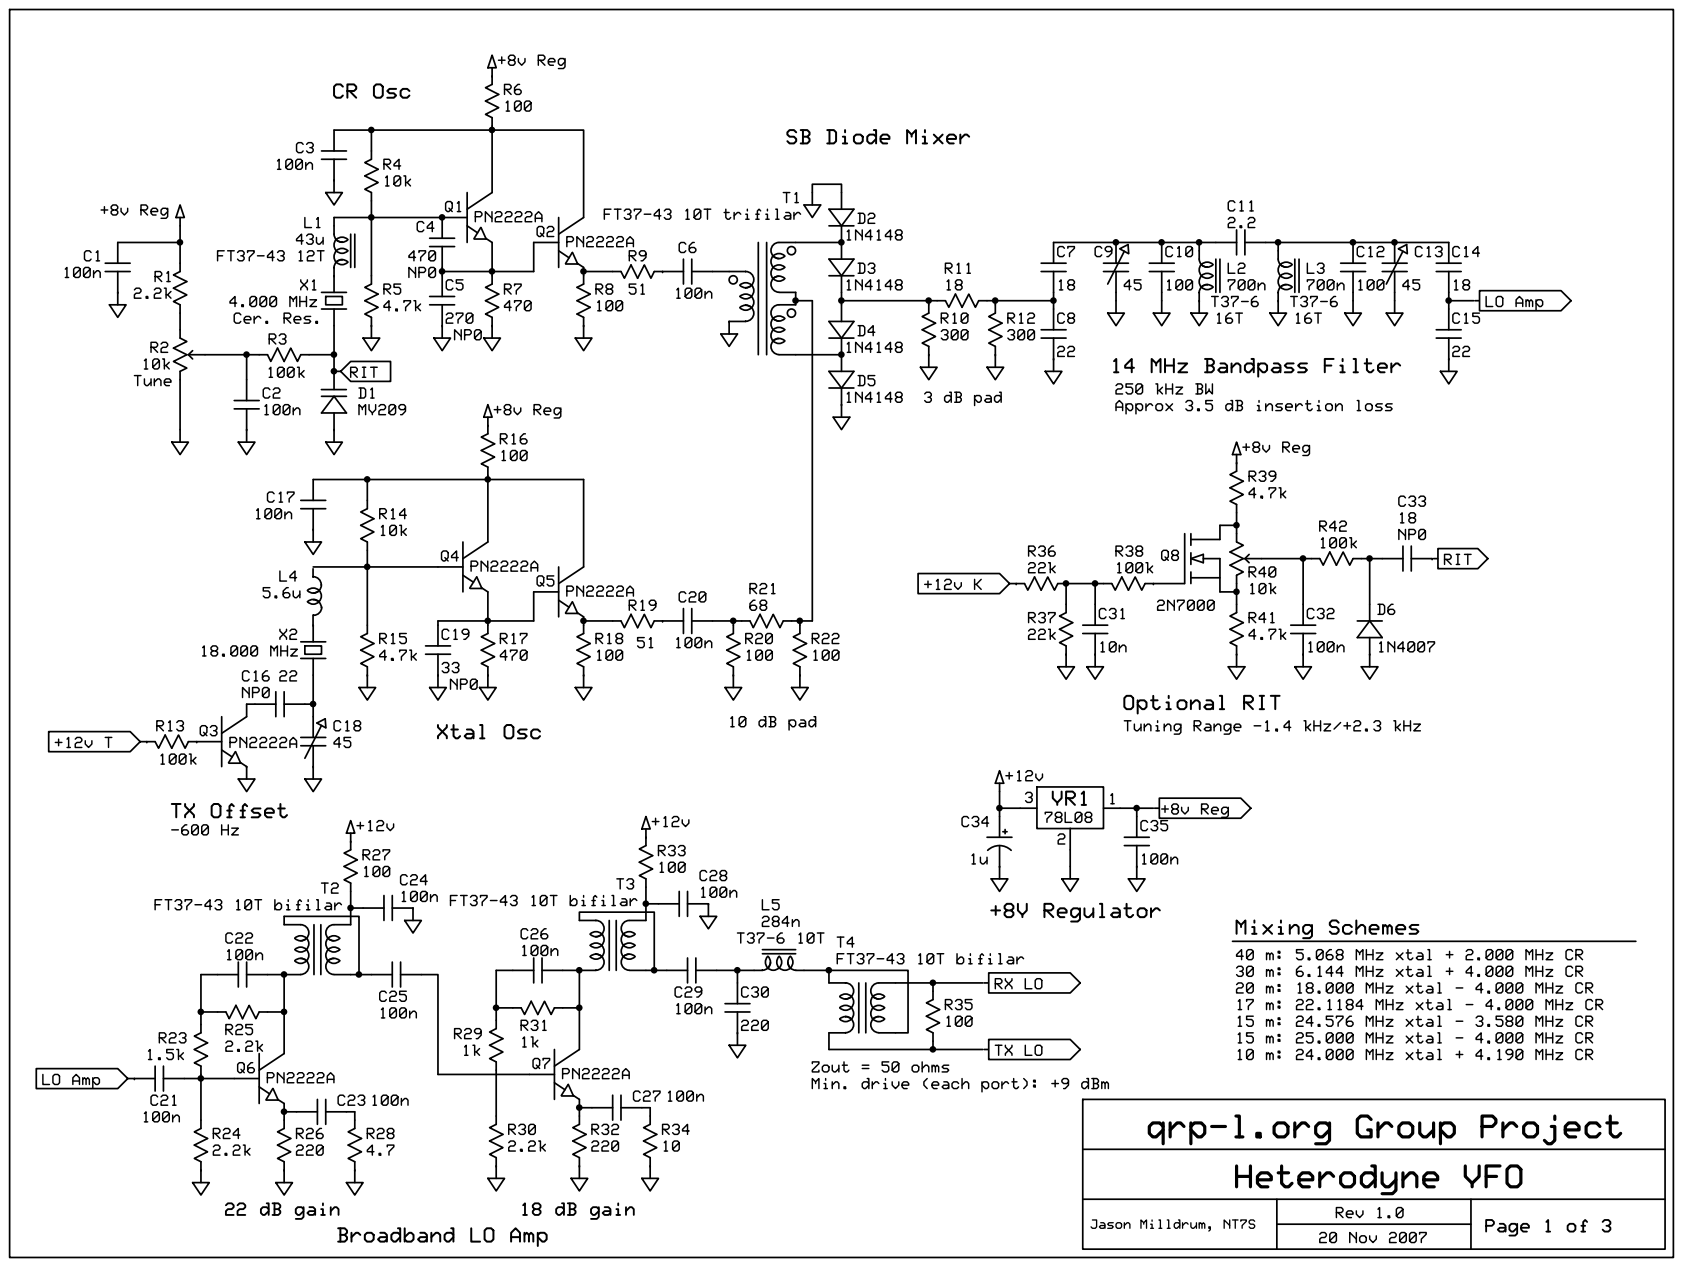
[picture p140: page 1]

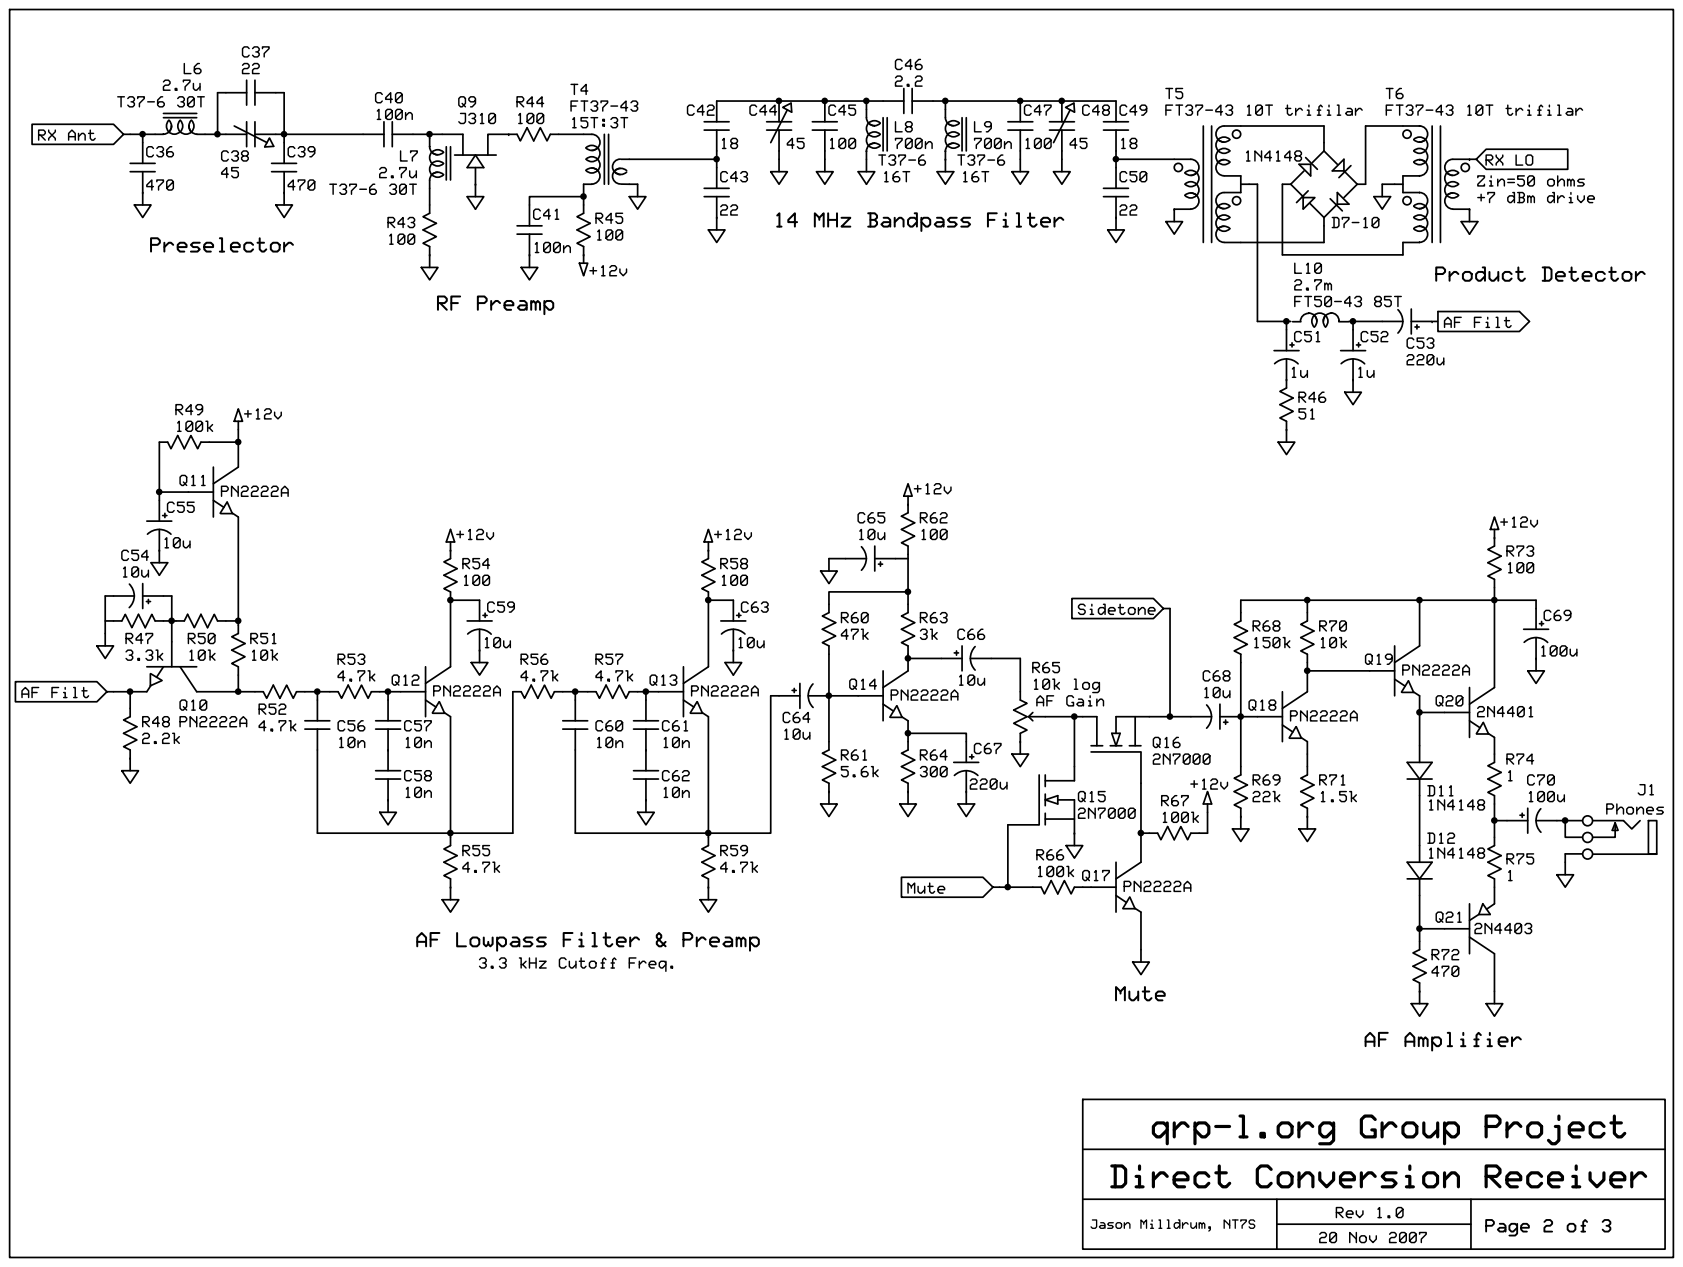
[picture p141: page 2]

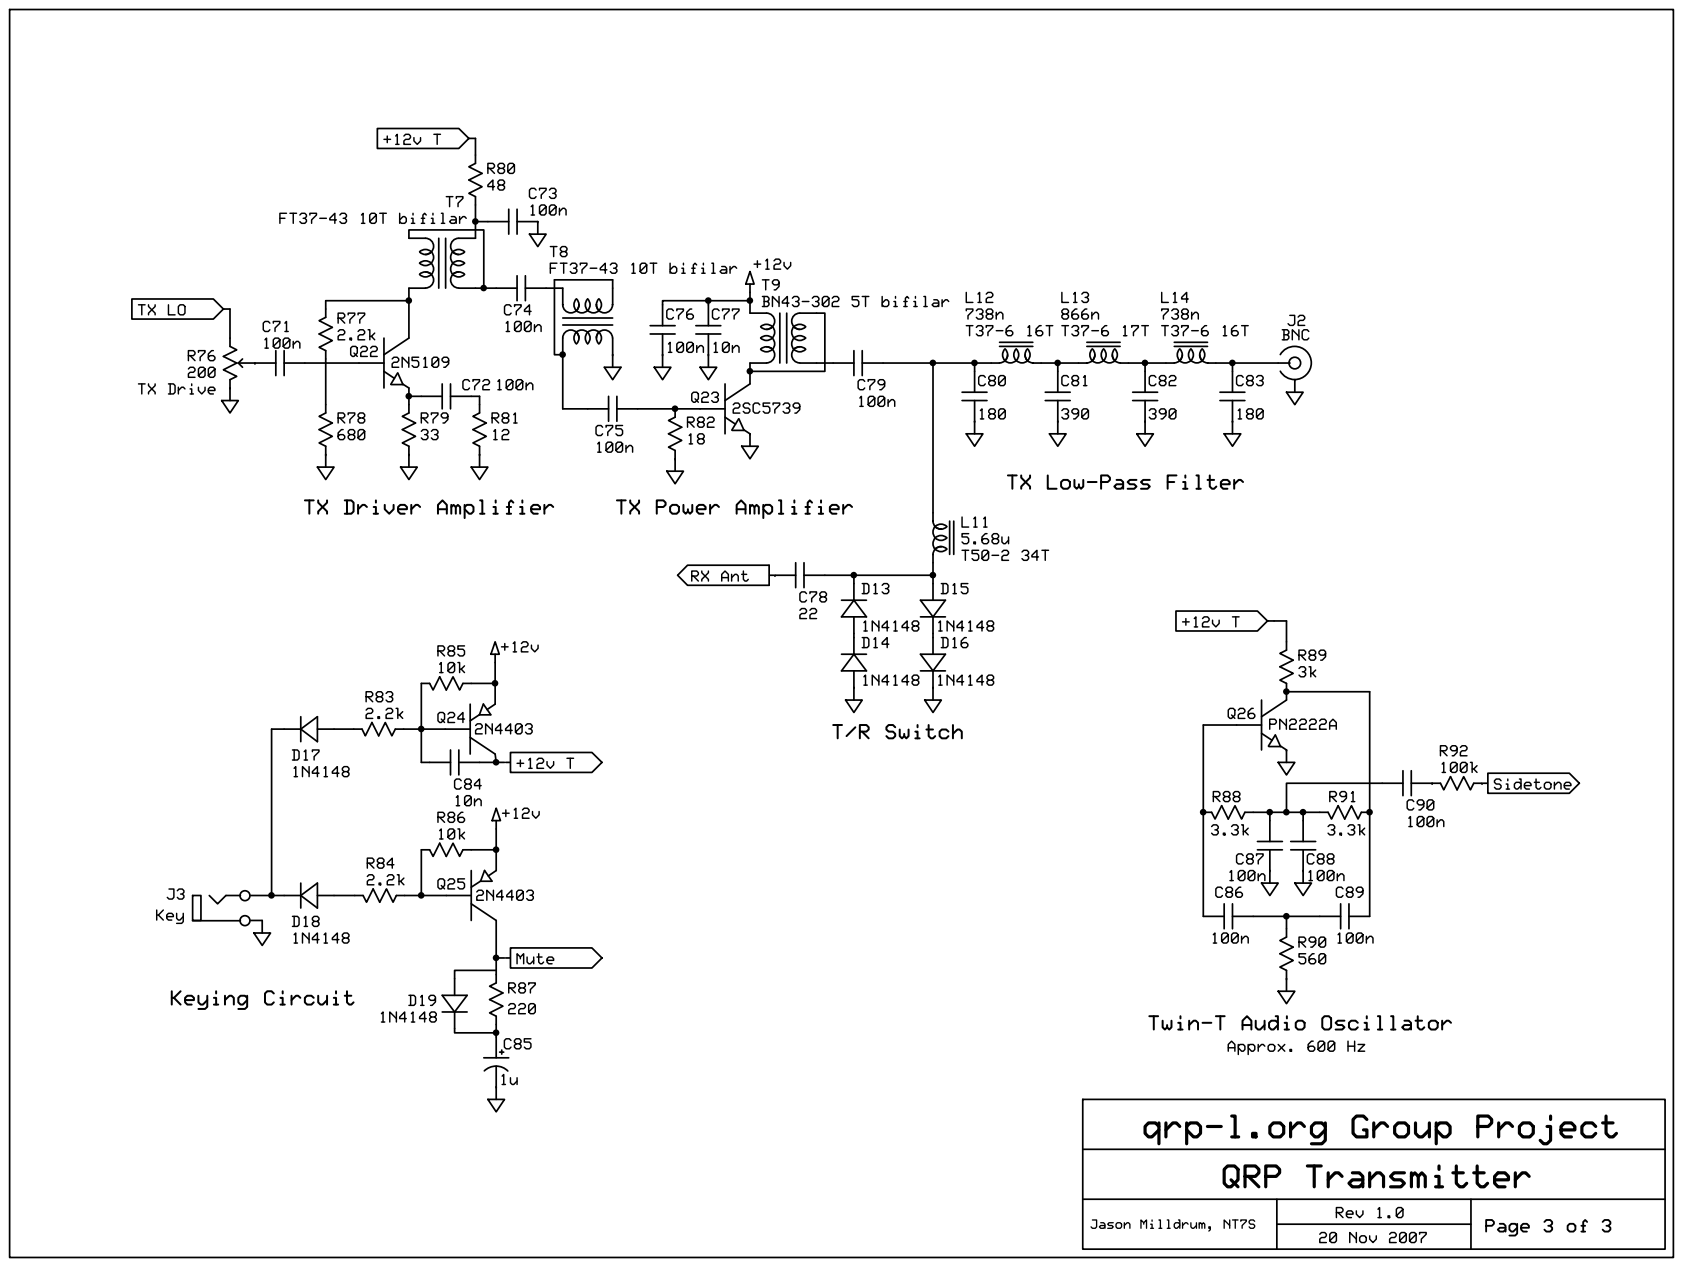
[picture p142: page 3]
