NT7S/WillametteTransceiver/Active AF Filter 2.asc

C1: cap; 10n
C2: cap; 10n
C3: cap; 220µ
C4: cap; 10n
C5: cap; 10µ
C6: cap; 10µ
C7: cap; 10n
C8: cap; 10n
C9: cap; 10n
C10: cap; 220µ
C12: cap; 10µ
C13: cap; 22µ
C14: cap; 22µ
C15: cap; 22µ
Q1: npn; 2N3904
Q2: npn; 2N3904
Q3: npn; 2N3904
Q4: npn; 2N3904
R1: res; 4.7k
R2: res; 470
R3: res; 4.7k
R4: res; 4.7k
R5: res; 47k
R6: res; 150k
R7: res; 22k
R8: res; 1.8k
R9: res; 100
R10: res; 5.6k
R11: res; 300
R12: res; 4.7k
R13: res; 4.7k
R14: res; 470
R15: res; 4.7k
R16: res; 4.7k
R17: res; 1G
R18: res; 4.6k
R19: res; 3.3k
V1: voltage; 12
V2: signal; ""; AC 2; Rser=50
V3: signal; ""; AC 1
Named nets: 0, VCC, In, S21, LP, S11
.ac dec 20 1 100Meg
