NT7S/WillametteTransceiver/Active AF Filter Peaked.asc

C1: cap; 100n
C2: cap; 1n
C3: cap; 220µ
C5: cap; 1µ
C6: cap; 10µ
C7: cap; 100n
C8: cap; 1n
C10: cap; 220µ
Q1: npn; 2N3904
Q2: npn; 2N3904
Q3: npn; 2N3904
Q4: npn; 2N3904
R1: res; 4.7k
R2: res; 470
R3: res; 24k
R4: res; 24k
R5: res; 47k
R6: res; 47k
R7: res; 110k
R8: res; 3k
R9: res; 100
R10: res; 5.6k
R11: res; 300
R12: res; 4.7k
R13: res; 4.7k
R14: res; 470
R15: res; 24k
R16: res; 24k
R17: res; 1G
R18: res; 4.6k
V1: voltage; 12
V2: signal; ""; AC 2; Rser=50
V3: signal; ""; AC 1
Named nets: 0, VCC, In, S21, LP
.ac dec 50 1 1Meg
