NT7S/WillametteTransceiver/AF Diplexer.asc

C1: cap; 1µ
C2: cap; 1µ
C3: cap; 220µ
L2: ind; 1m
R1: res; 51
R2: res; 50
R3: res; 1G
V1: signal; ""; AC 1
V2: signal; ""; AC 2; Rser=50
Named nets: 0, S21, S11
.ac dec 50 1 100Meg
