NT7S/WillametteTransceiver/Broadband RF Amp.asc

C1: cap; 0.1µ
C2: cap; 0.1µ
C3: cap; 0.1µ
C4: cap; 0.1µ
C5: cap; 0.1µ
L1: ind2; 30µ
L2: ind2; 30µ
Q1: npn; 2N2222
R1: res; 2.2k
R2: res; 2.2k
R3: res; 2.2k
R4: res; 220
R5: res; 4.7
R6: res; 100
R7: res; 1G
RLOAD: res; 50
V1: voltage; ""; AC 2; Rser=50
V2: voltage; 12
V3: voltage; ""; AC 1
Named nets: 0, S21, VIN, S11
K1 L1 L2 0.999
.ac dec 50 100k 100Meg
