NT7S/WillametteTransceiver/Common Base Amp.asc

C1: cap; 22µ
C2: cap; 220µ
C3: cap; 10µ
Q1: npn
R1: res; 2.2k
R2: res; 10k
R3: res; 10k
R4: res; 3.3k
R5: res; 3k
R6: res; 1G
V1: signal; ""; AC 2; Rser=50
V2: voltage; 12
V3: signal; ""; AC 1
Named nets: 0, +12V, S11, S21
.ac dec 50 1 100Meg
