NT7S/WillametteTransceiver/Diplexer.asc

C1: cap; 1µ
L1: ind; 1.5m
R1: res; 50
R2: res; 1G
V1: signal; ""; AC 2; Rser=50
V2: signal; ""; AC 1
Named nets: 0, S11, S21
.ac dec 50 1 100Meg
