NT7S/WillametteTransceiver/Output LP Filter.asc

C1: cap; 180p
C2: cap; 390p
C3: cap; 390p
C4: cap; 180p
L1: ind; 738n
L2: ind; 866n
L3: ind; 738n
R1: res; 50
V1: signal; ""; AC 1; Rser=50
Named nets: 0, S21
.ac dec 50 100k 100Meg
