NT7S/WillametteTransceiver/RF Driver.asc

C1: cap; 100n
C2: cap; 100n
C3: cap; 100n
C4: cap; 100n
L1: ind2; 30µ
L2: ind2; 30µ
Q1: npn; 2N2222
R1: res; 33
R2: res; 680
R3: res; 2.2k
R4: res; 15
R5: res; 50
R6: res; 48
V2: signal; SINE(0 2.5 14Meg); AC 2; Rser=200
V3: voltage; 12
Named nets: 0, S21, VCC
.tran 0 2u 0u 1n
K1 L1 L2 0.999
