NT7S/WillametteTransceiver/RF Preamp.asc

C1: cap; 100n
C2: cap; 100n
J1: njf; U309
L1: ind; 2.7µ
L2: ind2; 67.5µ
L3: ind2; 2.7µ
R1: res; 100
R2: res; 100
R3: res; 100
R4: res; 50
R5: res; 1G
V1: signal; ""; AC 1
V2: signal; ""; AC 2; Rser=50
V3: voltage; 12
Named nets: 0, VCC, S11, S21
K1 L2 L3 0.999
.ac dec 50 100k 100Meg
15T:3T
